tristantech/Dorm-Room-Automation/README.md

Dorm-Room-Automation
====================

Complete automation system for lights, A/V, doors, etc
