tristantech/Dorm-Room-Automation/Documents/DRCS Server Functions.docx

DRCS Control Functions

Lighting

see all channels

set channel, get channel

Audio / Music

now playing (Source name and song tags if available)

volume

play,pause,forward,back buttons for BT source

source

Door Security

current status

allow online door open? (risky)

Window

raise/lower blinds

enable/disable relay

current status (relay state, blind state, and window open sensor state)

Weather

current conditions

past archived weather

Webcam

view current frame

view archived images
