tristantech/Dorm-Room-Automation/Documents/DRCS Server Functions.pages/preview-web.jpg

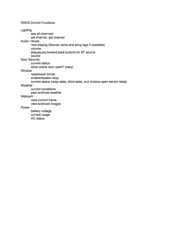
Documents/DRCS Server Functions.pages/preview-web.jpg
