tristantech/Dorm-Room-Automation/(list of files, cad)

Other CAD files:
Drawings/East Campus.dwg
