tristantech/Dorm-Room-Automation/Boards/Lighting/PWM_Board.pdf

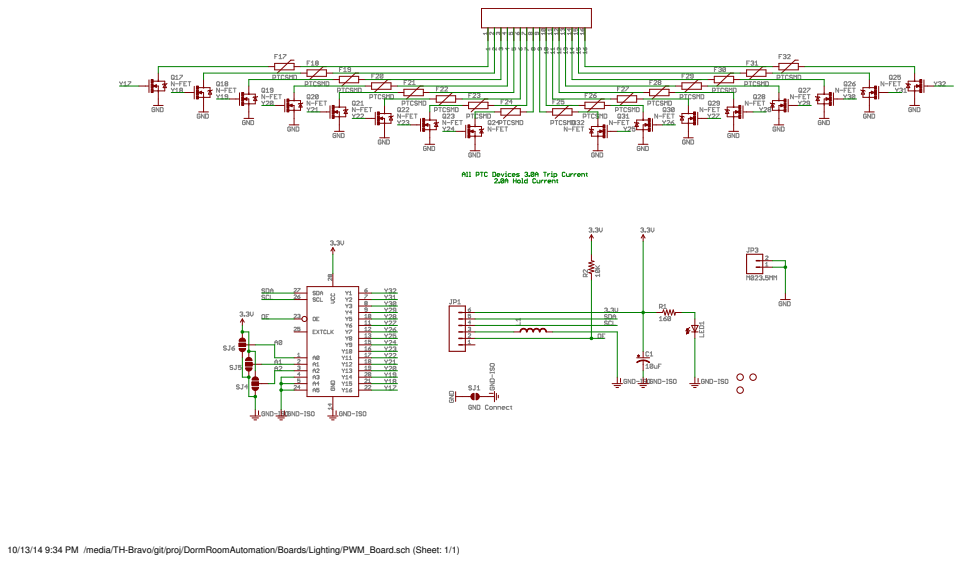
[picture p12: page 1]

10/13/14 9:34 PM /media/TH-Bravo/git/proj/DormRoomAutomation/Boards/Lighting/PWM_Board.sch (Sheet: 1/1)
