tristantech/Dorm-Room-Automation/Boards/plot.pdf

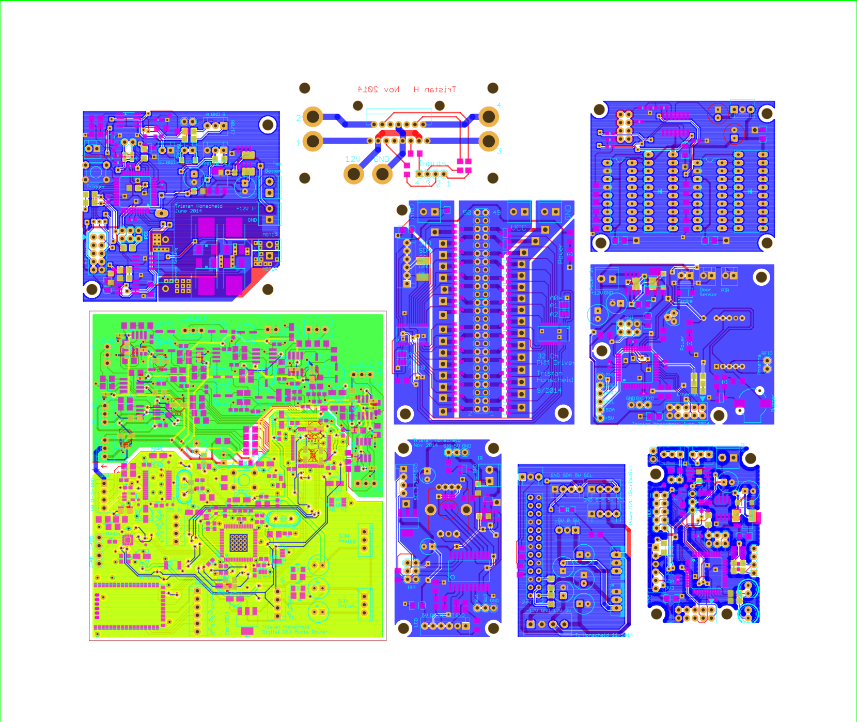
[picture p13: page 1]
