tristantech/Dorm-Room-Automation/Boards/Media/vu.brd

## EAGLE design Boards/Media/vu.brd (2014-12-12)

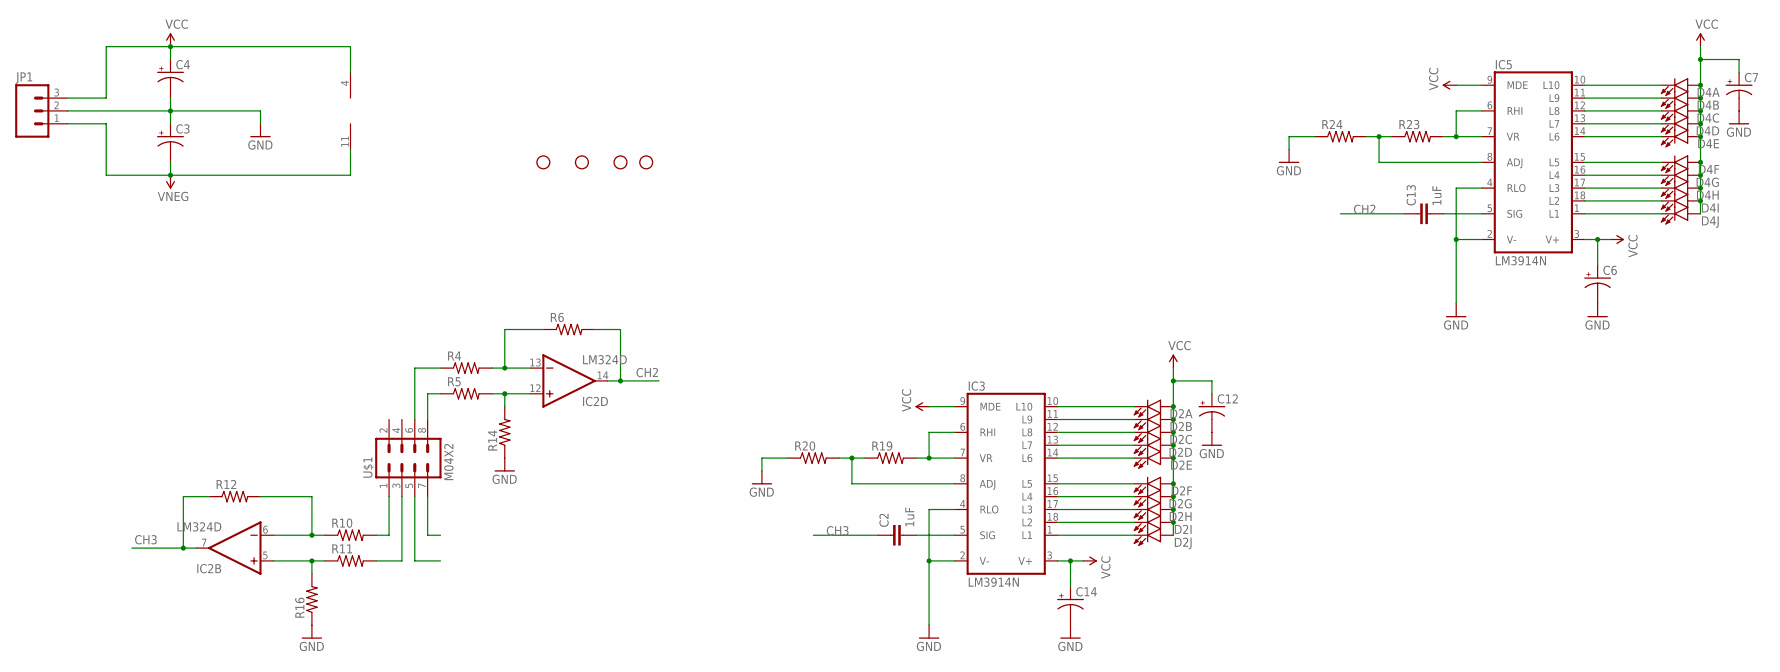
[picture p14: schematic vu.sch]

Parts:
C2, C13: 1uF; 1206
C3, C4: CAP_POLPTH1; CPOL-RADIAL-100UF-25V
C6, C7, C12, C14: CAP_POL1206; EIA3216
D2, D4: LED_BARGRAPH_10; LED_BARGAPH_10
IC2: LM324D; SO14
IC3, IC5: LM3914N; DIL18
JP1: M03POLAR; MOLEX-1X3
R4, R5, R6, R10, R11, R12, R14, R16: RESISTOR0603; 0603-RES
R19, R20, R23, R24: RESISTOR1206; 1206
STANDOFF1, STANDOFF2, STANDOFF3, STANDOFF4: STAND-OFF
U$1: M04X2; 2X4

Connections:
CH2: C13.1, IC2.14 (OUT), R6.2
CH3: C2.1, IC2.7 (OUT), R12.1
GND: C3.1 (+), C4.2 (-), C6.C (-), C7.C (-), C12.C (-), C14.C (-), IC3.2 (V-), IC3.4 (RLO), IC5.2 (V-), IC5.4 (RLO), JP1.2, R14.1, R16.1, R20.1, R24.1
unnamed: R11.2, U$1.3
unnamed: R10.2, U$1.1
unnamed: IC2.12 (+IN), R5.2, R14.2
unnamed: R4.1, U$1.6
unnamed: IC2.6 (-IN), R10.1, R12.2
unnamed: IC2.5 (+IN), R11.1, R16.2
unnamed: R5.1, U$1.8
unnamed: IC2.13 (-IN), R4.2, R6.1
unnamed: D2.19 (C), IC3.11 (L9)
unnamed: D2.18 (C), IC3.12 (L8)
unnamed: D2.17 (C), IC3.13 (L7)
unnamed: D2.16 (C), IC3.14 (L6)
unnamed: D2.15 (C), IC3.15 (L5)
unnamed: D2.14 (C), IC3.16 (L4)
unnamed: D2.13 (C), IC3.17 (L3)
unnamed: D2.12 (C), IC3.18 (L2)
unnamed: D2.11 (C), IC3.1 (L1)
unnamed: D2.20 (C), IC3.10 (L10)
unnamed: C2.2, IC3.5 (SIG)
unnamed: IC3.6 (RHI), IC3.7 (VR), R19.2
unnamed: IC3.8 (ADJ), R19.1, R20.2
unnamed: D4.19 (C), IC5.11 (L9)
unnamed: D4.18 (C), IC5.12 (L8)
unnamed: D4.17 (C), IC5.13 (L7)
unnamed: D4.16 (C), IC5.14 (L6)
unnamed: D4.15 (C), IC5.15 (L5)
unnamed: D4.14 (C), IC5.16 (L4)
unnamed: D4.13 (C), IC5.17 (L3)
unnamed: D4.12 (C), IC5.18 (L2)
unnamed: D4.11 (C), IC5.1 (L1)
unnamed: D4.20 (C), IC5.10 (L10)
unnamed: C13.2, IC5.5 (SIG)
unnamed: IC5.6 (RHI), IC5.7 (VR), R23.2
unnamed: IC5.8 (ADJ), R23.1, R24.2
VCC: C4.1 (+), C6.A (+), C7.A (+), C12.A (+), C14.A (+), D2.1 (A), D2.2 (A), D2.3 (A), D2.4 (A), D2.5 (A), D2.6 (A), D2.7 (A), D2.8 (A), D2.9 (A), D2.10 (A), D4.1 (A), D4.2 (A), D4.3 (A), D4.4 (A), D4.5 (A), D4.6 (A), D4.7 (A), D4.8 (A), D4.9 (A), D4.10 (A), IC2.4 (V+), IC3.3 (V+), IC3.9 (MDE), IC5.3 (V+), IC5.9 (MDE), JP1.3
VNEG: C3.2 (-), IC2.11 (V-), JP1.1

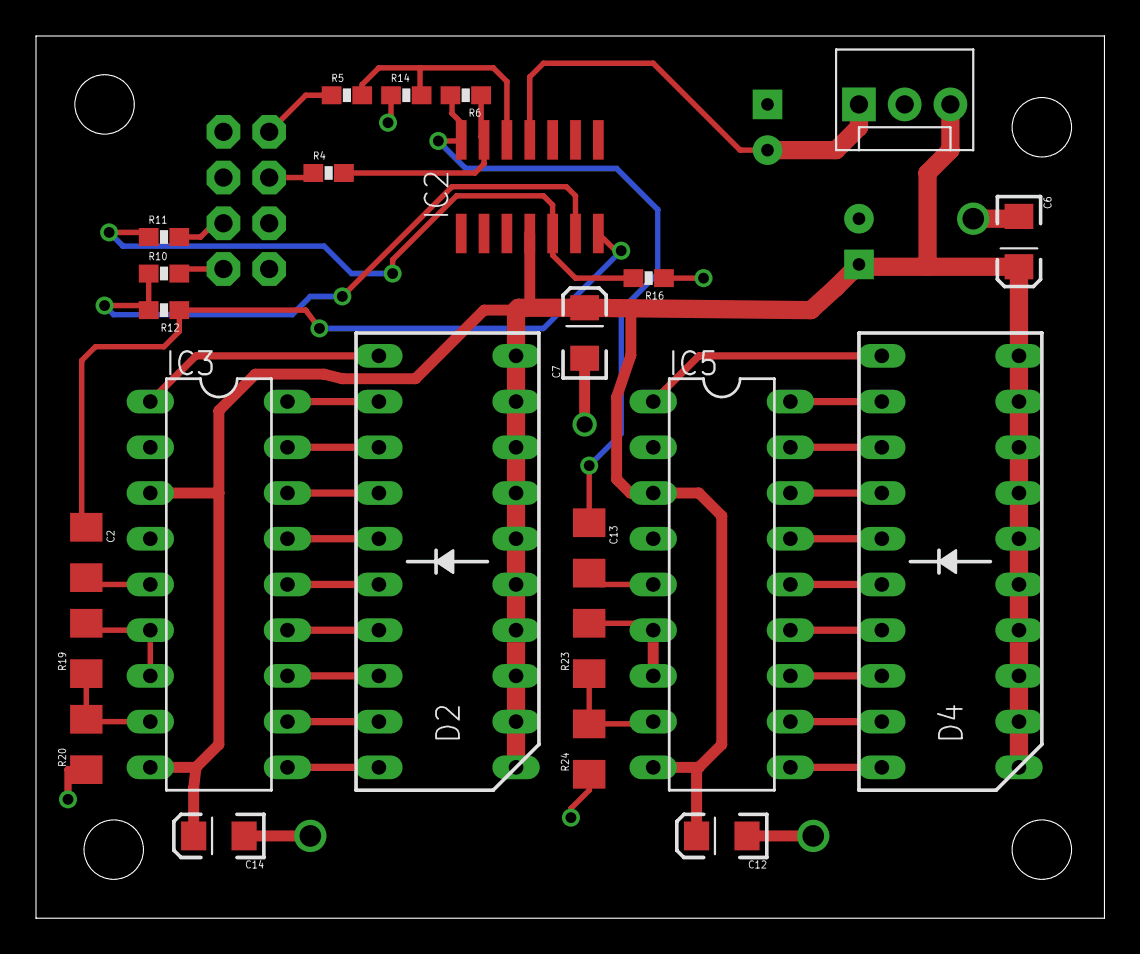
[picture p15: board vu.brd from above]

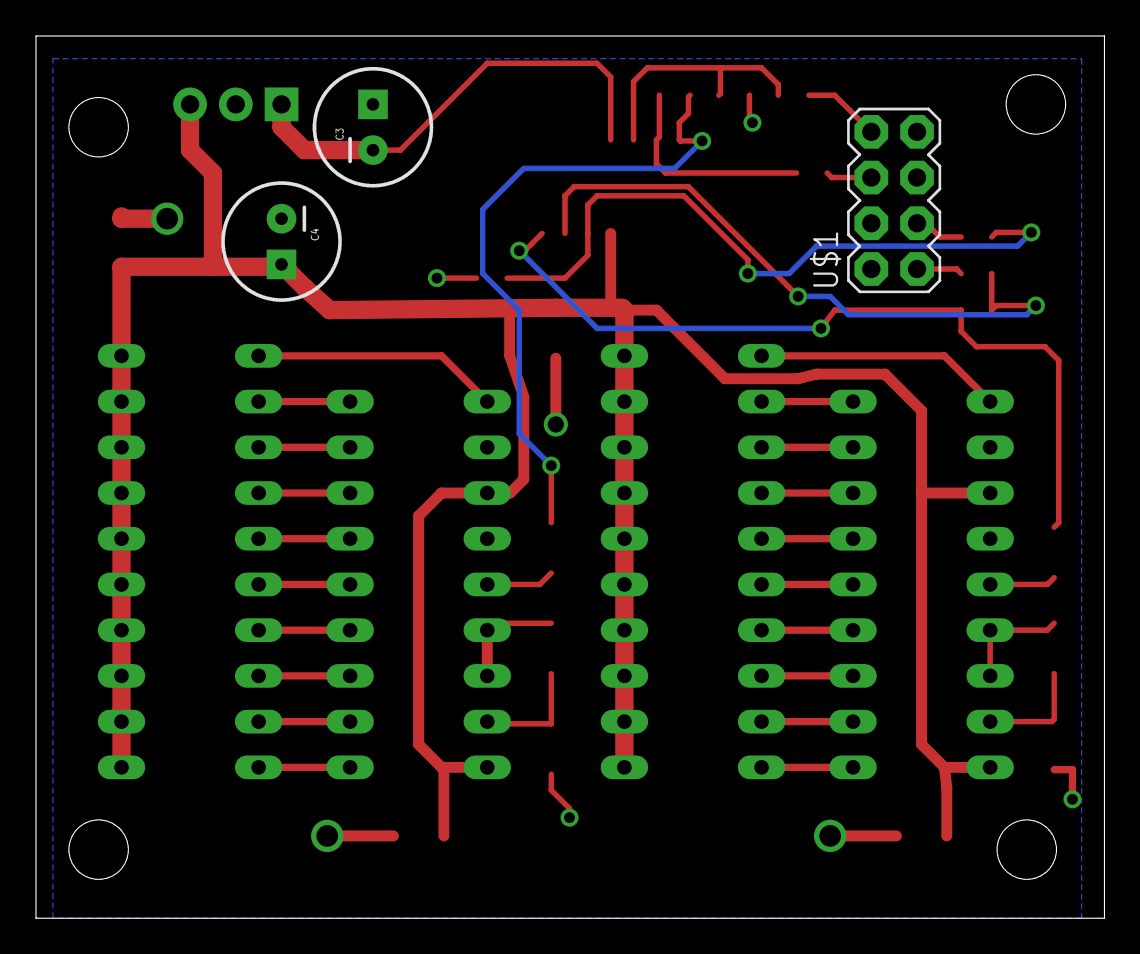
[picture p16: board vu.brd from below]

Board: 2 copper layers, 59.4 x 49.0 mm, 31 parts (3 on the bottom side), 39 nets.
