tristantech/Dorm-Room-Automation/Boards/Media/dsp.brd

## EAGLE design Boards/Media/dsp.brd (2014-12-12)

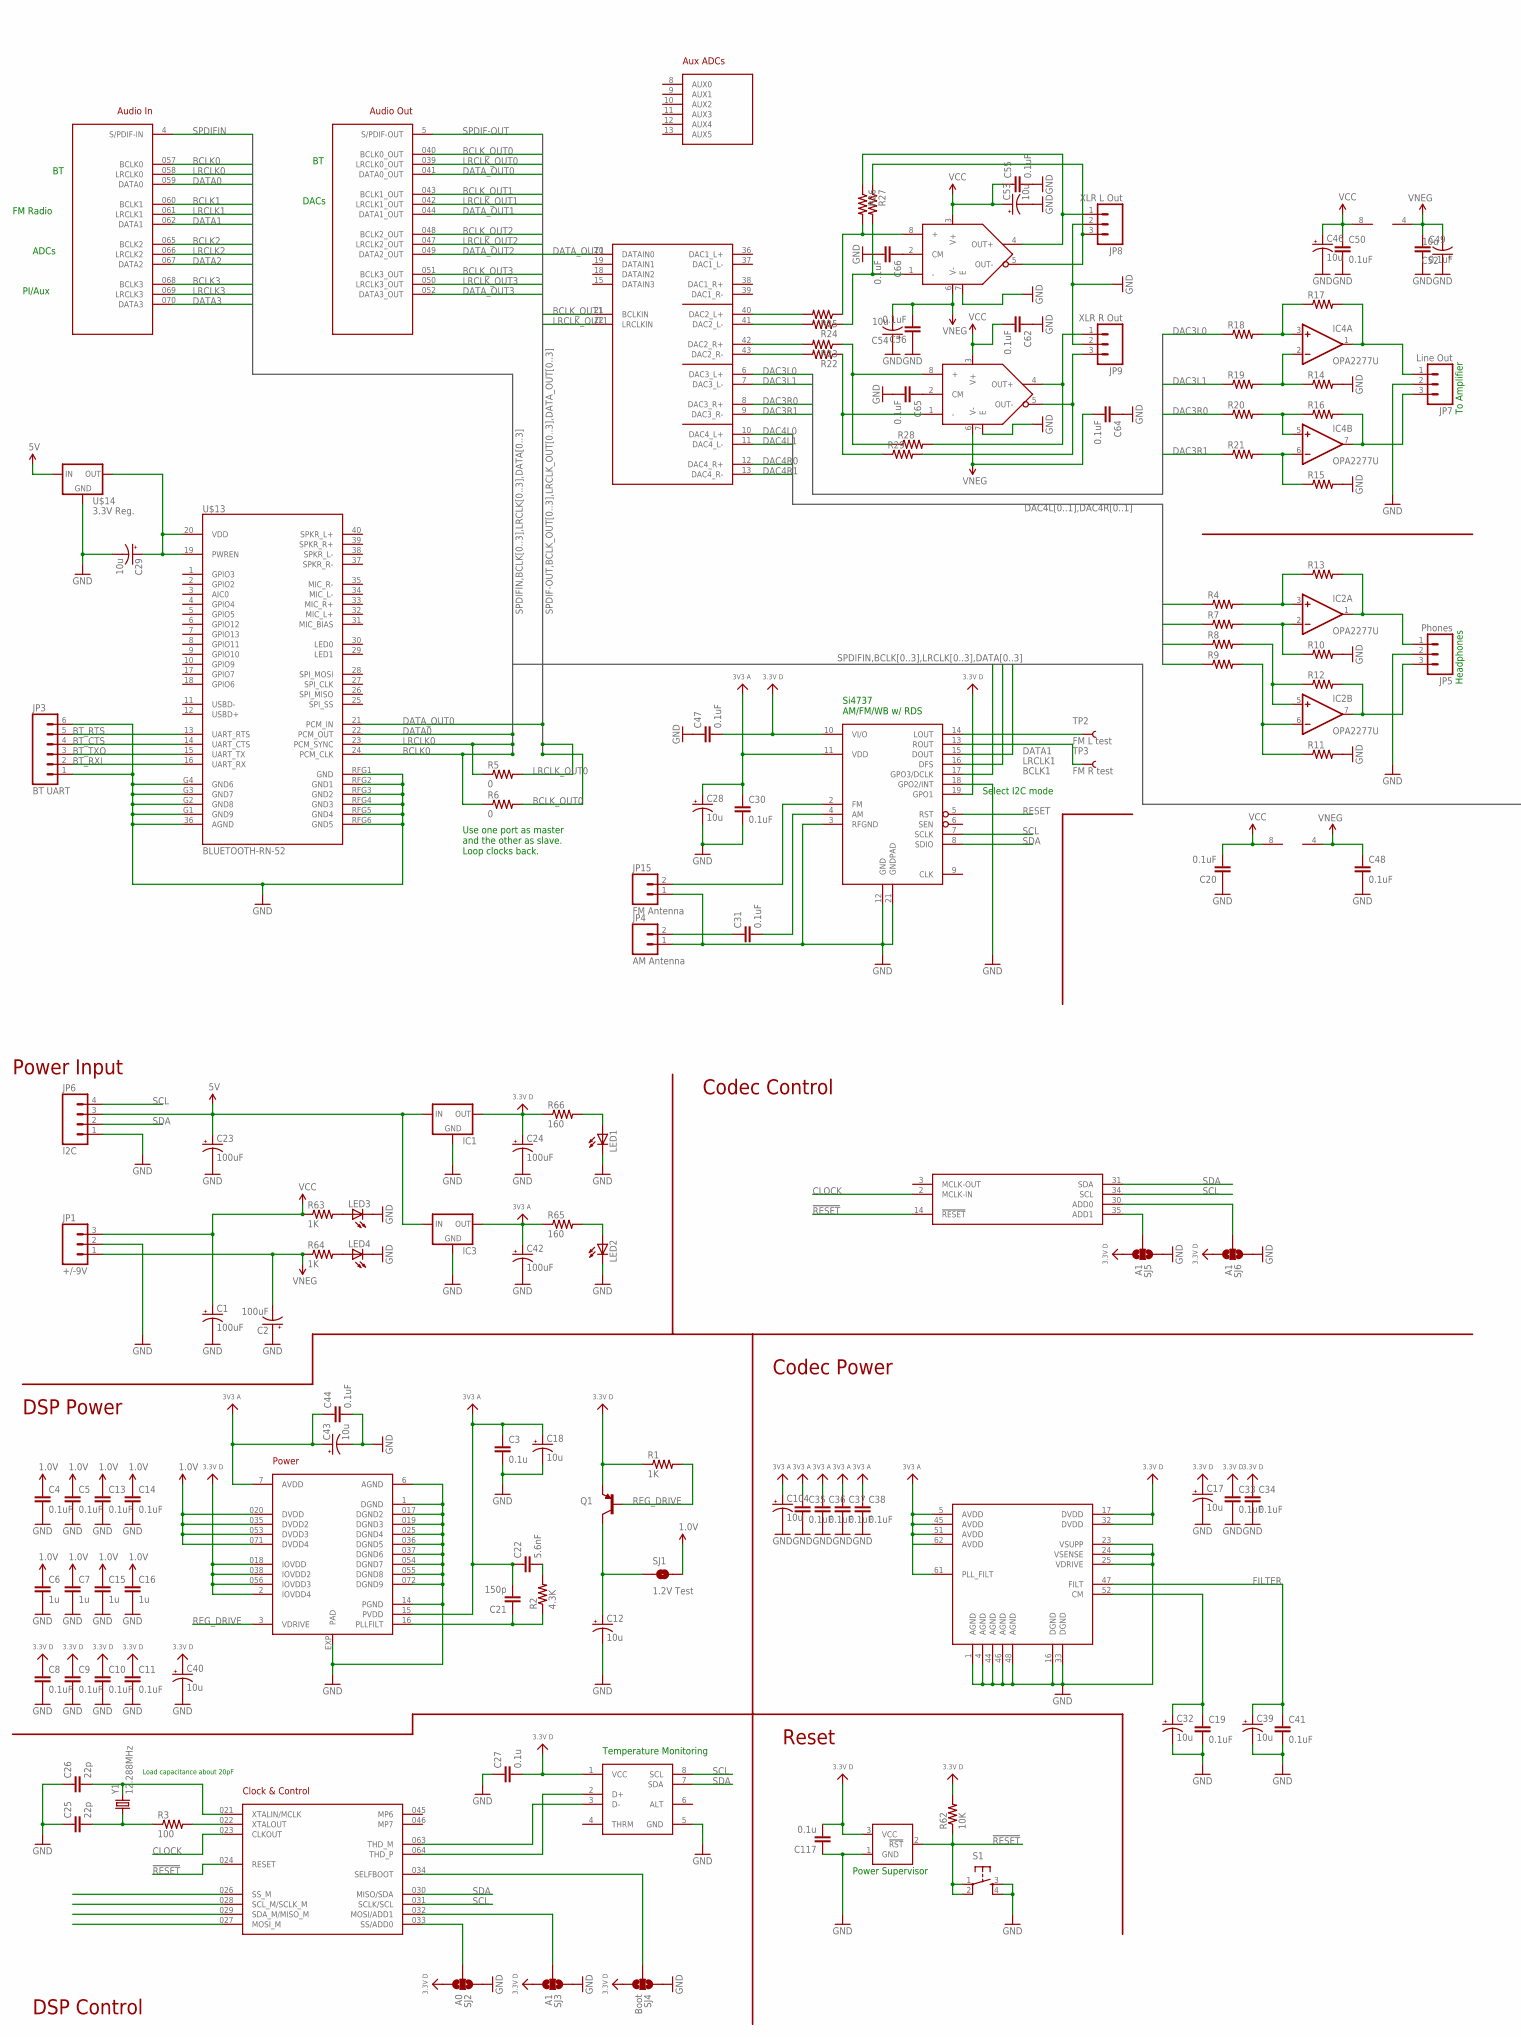
[picture p17: schematic dsp.sch, sheet 1, part in row 1, column 1]

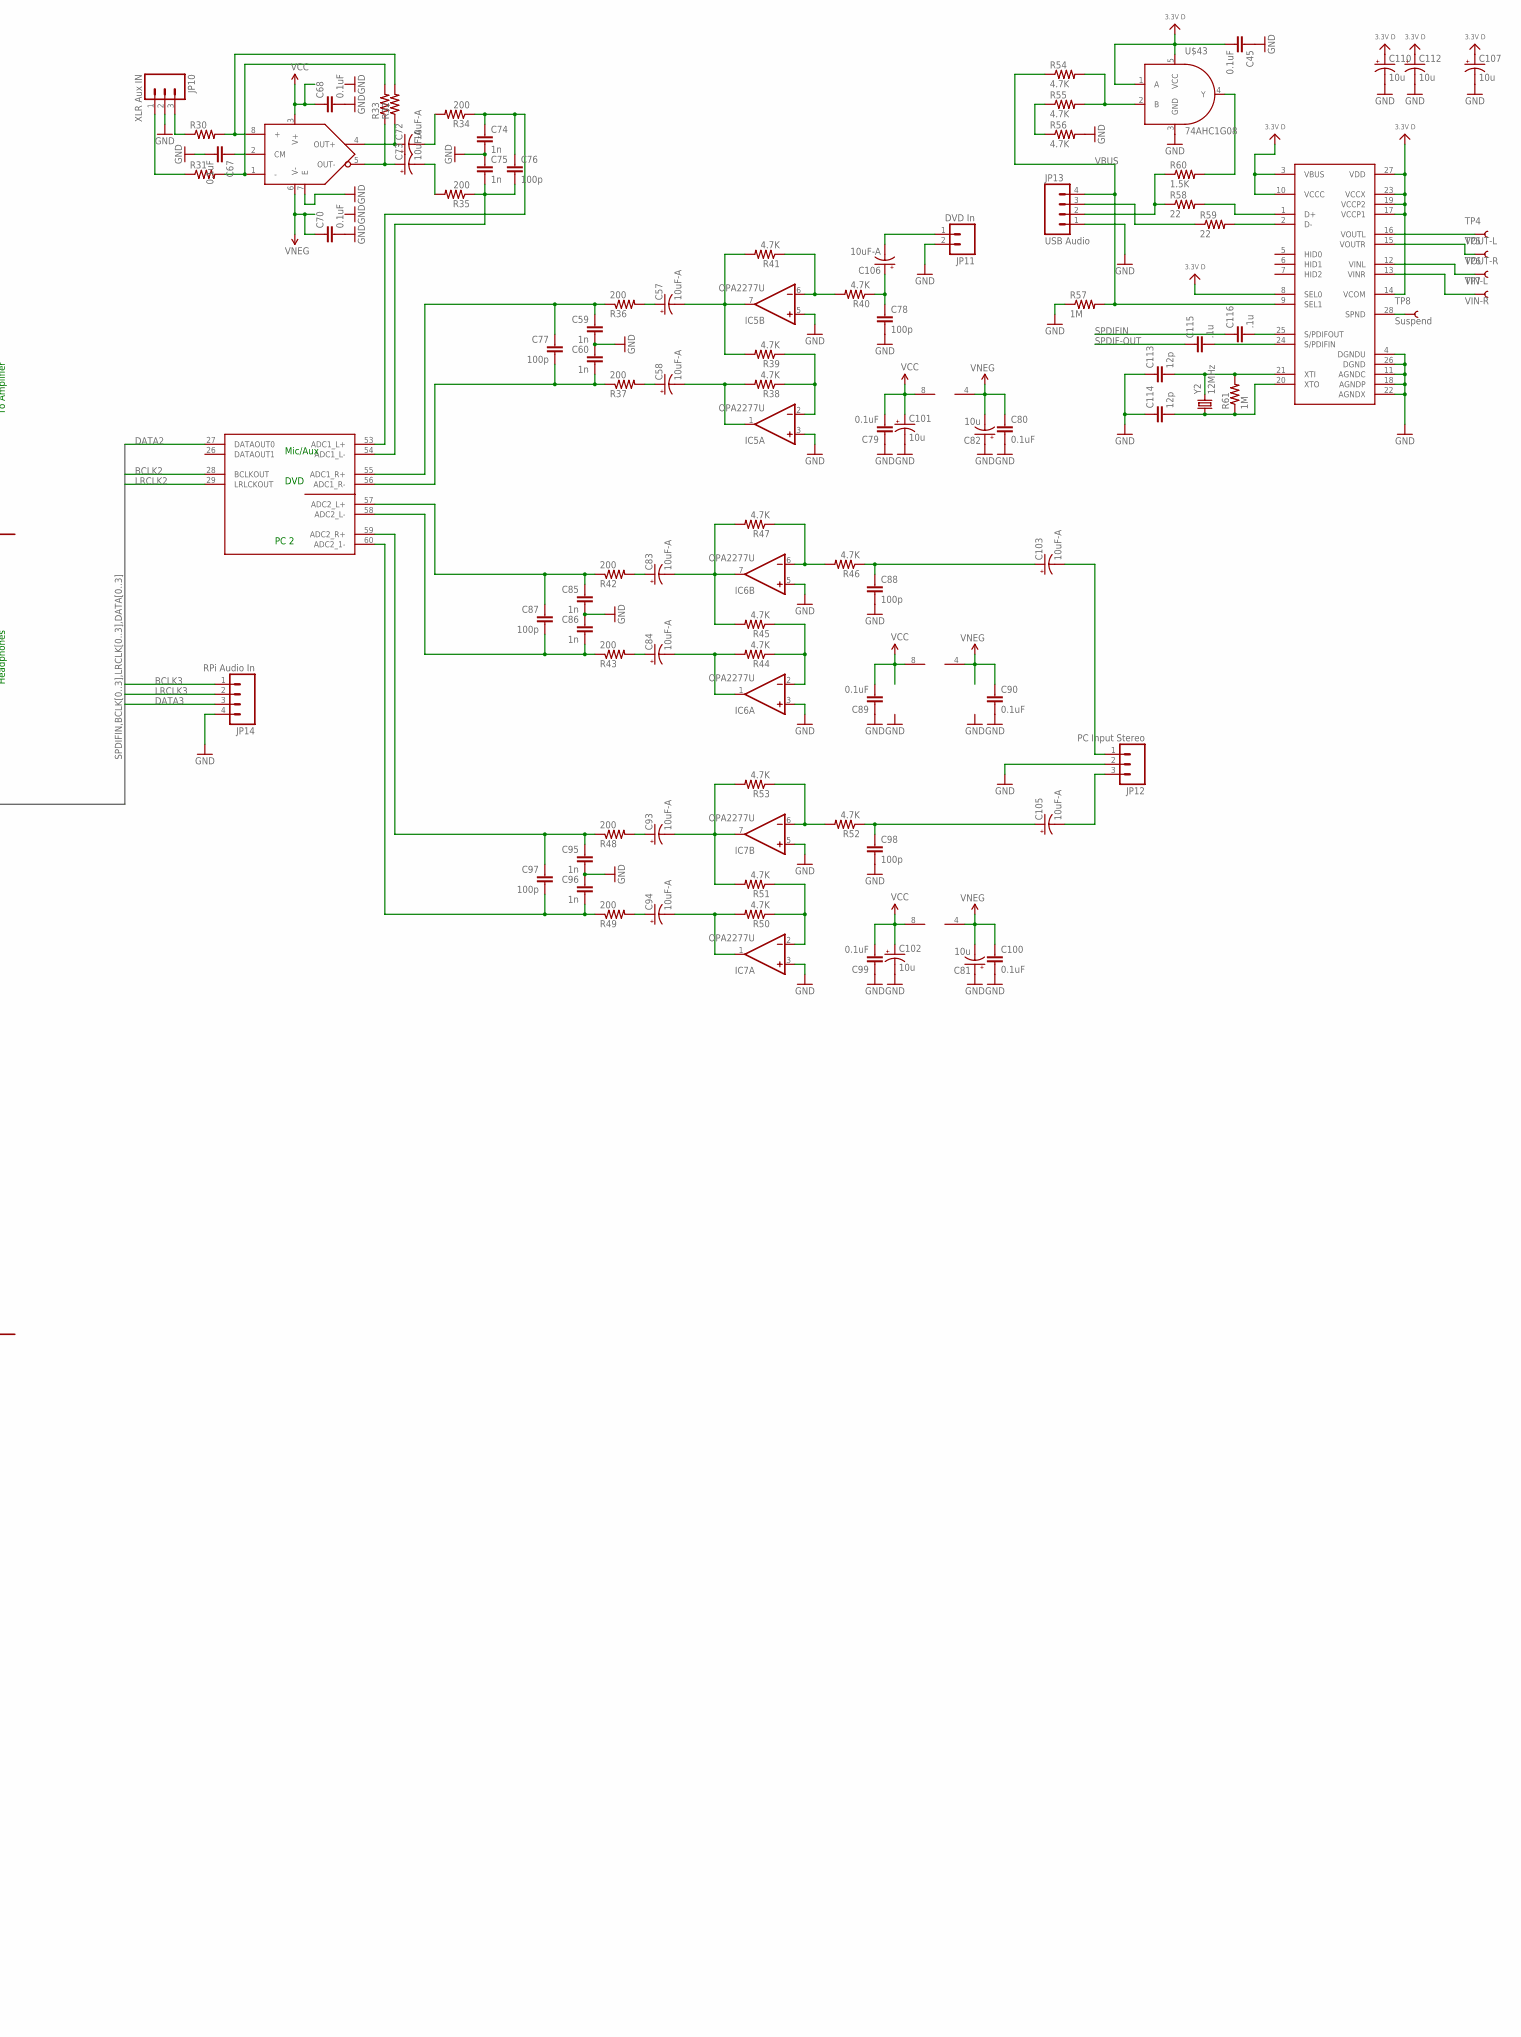
[picture p18: schematic dsp.sch, sheet 1, part in row 1, column 2]

Parts:
C1, C2, C23, C24, C42: 100uF; CPOL-RADIAL-100UF-25V
C3, C27, C117: 0.1u; 0603-CAP
C4, C5, C8, C9, C10, C11, C13, C14, C19, C20, C30, C31, C33, C34, C35, C36, C37, C38, C41, C44, C45, C47, C48, C49, C50, C55, C56, C62, C64, C65, C66, C67, C68, C70, C79, C80, C89, C90, C99, C100: 0.1uF; 0603-CAP
C6, C7, C15, C16: 1u; 0603-CAP
C12, C17, C18, C28, C29, C32, C39, C40, C43, C46, C52, C53, C54, C81, C82, C101, C102, C104, C107, C110, C112: 10u; PANASONIC_B
C21: 150p; 0603-CAP
C22: 5.6nF; 0603-CAP
C25, C26: 22p; 0603-CAP
C57, C58, C72, C73, C83, C84, C93, C94, C103, C105, C106: 10uF-A; PANASONIC_C
C59, C60, C74, C75, C85, C86, C95, C96: 1n; 0603-CAP
C76, C77, C78, C87, C88, C97, C98: 100p; 0603-CAP
C113, C114: 12p; 0603-CAP
C115, C116: .1u; 0603-CAP
IC1, IC3: V_REG_78XXSINK; TO220-IGO
IC2, IC4, IC5, IC6, IC7: OPA2277U; SO08
JP1: +/-9V; MOLEX-1X3
JP3: BT UART; MOLEX-1X6
JP4: AM Antenna; 1X02
JP5: Phones; MOLEX-1X3
JP6: I2C; MOLEX-1X4
JP7: Line Out; MOLEX-1X3
JP8: XLR L Out; MOLEX-1X3
JP9: XLR R Out; MOLEX-1X3
JP10: XLR Aux IN; MOLEX-1X3
JP11: DVD In; MOLEX-1X2
JP12: PC Input Stereo; MOLEX-1X3
JP13: USB Audio; MOLEX-1X4
JP14: RPi Audio In; MOLEX-1X4
JP15: FM Antenna; 1X02
LED1, LED2, LED3, LED4: LED1206; LED-1206
Q1: TRANSISTOR_PNPSMD; SOT23-3
R1, R63, R64: 1K; 1206
R2: 4.3K; 1206
R3: 100; 1206
R4, R7, R8, R9, R10, R11, R12, R13, R14, R15, R16, R17, R18, R19, R20, R21, R22, R23, R24, R25, R26, R27, R28, R29, R30, R31, R32, R33: RESISTOR1206; 1206
R5, R6: 0; 1206
R34, R35, R36, R37, R42, R43, R48, R49: 200; 1206
R38, R39, R40, R41, R44, R45, R46, R47, R50, R51, R52, R53, R54, R55, R56: 4.7K; 1206
R57, R61: 1M; 1206
R58, R59: 22; 1206
R60: 1.5K; 1206
R62: 10K; 1206
R65, R66: 160; 1206
S1: TAC_SWITCHPTH; TACTILE-PTH
SJ1: 1.2V Test; SJ_2S-NO
SJ2: A0; SJ_3
SJ3, SJ5, SJ6: A1; SJ_3
SJ4: Boot; SJ_3
TP2: FM L test; PAD.03X.03
TP3: FM R test; PAD.03X.03
TP4: VOUT-L; PAD.03X.03
TP5: VOUT-R; PAD.03X.03
TP6: VIN-L; PAD.03X.03
TP7: VIN-R; PAD.03X.03
TP8: Suspend; PAD.03X.03
U$1: ADAU1451; LFCSP-72
U$8: ADM1032; MSOP-8
U$13: BLUETOOTH-RN-52; RN-52
U$14: 3.3V Reg.; SOT223
U$15: SI4736/37/38/39; QFN-16
U$17: AD1937; LQFP-64
U$35, U$38, U$39: LME49724; SOIC-8
U$40: PCM2903; SSOP-28
U$43: 74AHC1G08; SOT23-5
U$52: TLV803; SOT23
Y1: 12.288MHz; HC49U-V
Y2: 12MHz; HC49U-V

Connections:
1.0V: C4.1, C5.1, C6.1, C7.1, C13.1, C14.1, C15.1, C16.1, SJ1.2, U$1.020 (DVDD), U$1.035 (DVDD2), U$1.053 (DVDD3), U$1.071 (DVDD4)
3.3V_A: C3.1, C18.+, C21.2, C22.1, C28.+, C30.1, C35.1, C36.1, C37.1, C38.1, C42.1 (+), C43.+, C44.1, C104.+, IC3.OUT, R65.1, U$1.7 (AVDD), U$1.15 (PVDD), U$15.11 (VDD), U$17.5 (AVDD), U$17.45 (AVDD), U$17.51 (AVDD), U$17.61 (PLL_FILT), U$17.62 (AVDD)
3V3_D: C8.1, C9.1, C10.1, C11.1, C17.+, C24.1 (+), C27.2, C33.1, C34.1, C40.+, C45.2, C47.2, C107.+, C110.+, C112.+, C117.2, IC1.OUT, Q1.2 (E), R1.1, R62.2, R66.1, SJ2.3, SJ3.3, SJ4.3, SJ5.3, SJ6.3, U$1.2 (IOVDD4), U$1.018 (IOVDD), U$1.038 (IOVDD2), U$1.056 (IOVDD3), U$8.1 (VCC), U$15.10 (VI/O), U$15.19 (GPO1), U$17.17 (DVDD), U$17.32 (DVDD), U$40.3 (VBUS), U$40.8 (SEL0), U$40.10 (VCCC), U$40.14 (VCOM), U$40.17 (VCCP1), U$40.19 (VCCP2), U$40.23 (VCCX), U$40.27 (VDD), U$43.1 (A), U$43.5 (VCC), U$52.3 (VCC)
5V: C23.1 (+), IC1.IN, IC3.IN, JP6.3, U$14.1 (IN)
!RESET: R62.1, S1.1, S1.2, U$1.024 (RESET), U$17.14 (!RESET), U$52.2 (!RST)
BCLK0: R6.1, U$1.057 (BCLK0), U$13.24 (PCM_CLK)
BCLK1: U$1.060 (BCLK1), U$15.17 (GPO3/DCLK)
BCLK2: U$1.065 (BCLK2), U$17.28 (BCLKOUT)
BCLK3: JP14.1, U$1.068 (BCLK3)
BCLK_OUT0: R6.2, U$1.040 (BCLK0_OUT)
BCLK_OUT1: U$1.043 (BCLK1_OUT), U$17.21 (BCLKIN)
BCLK_OUT2: U$1.048 (BCLK2_OUT)
BCLK_OUT3: U$1.051 (BCLK3_OUT)
BT_CTS: JP3.4, U$13.14 (UART_CTS)
BT_RTS: JP3.5, U$13.13 (UART_RTS)
BT_RXI: JP3.2, U$13.16 (UART_RX)
BT_TXO: JP3.3, U$13.15 (UART_TX)
CLOCK: U$1.023 (CLKOUT), U$17.2 (MCLK-IN)
DAC3L0: R18.1, U$17.6 (DAC3_L+)
DAC3L1: R19.1, U$17.7 (DAC3_L-)
DAC3R0: R20.1, U$17.8 (DAC3_R+)
DAC3R1: R21.1, U$17.9 (DAC3_R-)
DAC4L0: R4.1, U$17.10 (DAC4_L+)
DAC4L1: R7.1, U$17.11 (DAC4_L-)
DAC4R0: R8.1, U$17.12 (DAC4_R+)
DAC4R1: R9.1, U$17.13 (DAC4_R-)
DATA0: U$1.059 (DATA0), U$13.22 (PCM_OUT)
DATA1: U$1.062 (DATA1), U$15.15 (DOUT)
DATA2: U$1.067 (DATA2), U$17.27 (DATAOUT0)
DATA3: JP14.3, U$1.070 (DATA3)
DATA_OUT0: U$1.041 (DATA0_OUT), U$13.21 (PCM_IN)
DATA_OUT1: U$1.044 (DATA1_OUT), U$17.20 (DATAIN0)
DATA_OUT2: U$1.049 (DATA2_OUT)
DATA_OUT3: U$1.052 (DATA3_OUT)
FILTER: C39.+, C41.1, U$17.47 (FILT)
FM: JP15.2, U$15.2 (FM)
GND: C1.2 (-), C2.1 (+), C3.2, C4.2, C5.2, C6.2, C7.2, C8.2, C9.2, C10.2, C11.2, C12.-, C13.2, C14.2, C15.2, C16.2, C17.-, C18.-, C19.2, C20.1, C23.2 (-), C24.2 (-), C25.1, C26.1, C27.1, C28.-, C29.-, C30.2, C32.-, C33.2, C34.2, C35.2, C36.2, C37.2, C38.2, C39.-, C40.-, C41.2, C42.2 (-), C43.-, C44.2, C45.1, C46.-, C47.1, C48.2, C49.2, C50.2, C52.+, C53.-, C54.+, C55.2, C56.1, C59.2, C60.1, C62.1, C64.1, C65.2, C66.2, C67.2, C68.2, C70.2, C74.2, C75.1, C78.2, C79.1, C80.2, C81.+, C82.+, C85.2, C86.1, C88.2, C89.1, C90.2, C95.2, C96.1, C98.2, C99.1, C100.2, C101.-, C102.-, C104.-, C107.-, C110.-, C112.-, C113.1, C114.1, C117.1, IC1.GND, IC3.GND, IC5.3 (+IN), IC5.5 (+IN), IC6.3 (+IN), IC6.5 (+IN), IC7.3 (+IN), IC7.5 (+IN), JP1.2, JP3.1, JP3.6, JP4.1, JP5.2, JP6.1, JP7.2, JP8.2, JP9.2, JP10.2, JP11.2, JP12.2, JP13.1, JP14.4, JP15.1, LED1.C, LED2.C, LED3.C, LED4.C, R10.2, R11.2, R14.2, R15.2, R56.2, R57.1, S1.3, S1.4, SJ2.1, SJ3.1, SJ4.1, SJ5.1, SJ6.1, U$1.1 (DGND), U$1.6 (AGND), U$1.14 (PGND), U$1.017 (DGND2), U$1.019 (DGND3), U$1.025 (DGND4), U$1.036 (DGND5), U$1.037 (DGND6), U$1.054 (DGND7), U$1.055 (DGND8), U$1.072 (DGND9), U$1.EXP (PAD), U$8.5 (GND), U$13.36 (AGND), U$13.G1 (GND9), U$13.G2 (GND8), U$13.G3 (GND7), U$13.G4 (GND6), U$13.RFG1 (GND), U$13.RFG2 (GND1), U$13.RFG3 (GND2), U$13.RFG4 (GND3), U$13.RFG5 (GND4), U$13.RFG6 (GND5), U$14.2 (GND), U$15.3 (RFGND), U$15.12 (GND), U$15.18 (GPO2/INT), U$15.21 (GNDPAD), U$17.1 (AGND), U$17.4 (AGND), U$17.16 (DGND), U$17.23 (VSUPP), U$17.24 (VSENSE), U$17.25 (VDRIVE), U$17.33 (DGND), U$17.44 (AGND), U$17.46 (AGND), U$17.48 (AGND), U$35.7 (E), U$38.7 (E), U$39.7 (E), U$40.4 (DGNDU), U$40.11 (AGNDC), U$40.18 (AGNDP), U$40.22 (AGNDX), U$40.26 (DGND), U$43.3 (GND), U$52.1 (GND)
LRCLK0: R5.1, U$1.058 (LRCLK0), U$13.23 (PCM_SYNC)
LRCLK1: U$1.061 (LRCLK1), U$15.16 (DFS)
LRCLK2: U$1.066 (LRCLK2), U$17.29 (LRLCKOUT)
LRCLK3: JP14.2, U$1.069 (LRCLK3)
LRCLK_OUT0: R5.2, U$1.039 (LRCLK0_OUT)
LRCLK_OUT1: U$1.042 (LRCLK1_OUT), U$17.22 (LRCLKIN)
LRCLK_OUT2: U$1.047 (LRCLK2_OUT)
LRCLK_OUT3: U$1.050 (LRCLK3_OUT)
unnamed: C21.1, R2.1, U$1.16 (PLLFILT)
unnamed: C22.2, R2.2
unnamed: R3.2, U$1.022 (XTALOUT)
unnamed: C12.+, Q1.3 (C), SJ1.1
unnamed: C26.2, U$1.021 (XTALIN/MCLK), Y1.2
unnamed: C25.2, R3.1, Y1.1
unnamed: C19.1, C32.+, U$17.52 (CM)
unnamed: U$1.063 (THD_M), U$8.3 (D-)
unnamed: U$1.064 (THD_P), U$8.2 (D+)
unnamed: SJ4.2, U$1.034 (SELFBOOT)
unnamed: SJ3.2, U$1.032 (MOSI/ADD1)
unnamed: SJ2.2, U$1.033 (SS/ADD0)
unnamed: C29.+, U$13.19 (PWREN), U$13.20 (VDD), U$14.3 (OUT)
unnamed: IC2.1 (OUT), JP5.1, R13.2
unnamed: IC2.3 (+IN), R4.2, R13.1
unnamed: C31.2, U$15.4 (AM)
unnamed: C31.1, JP4.2
unnamed: TP2.P$1, U$15.14 (LOUT)
unnamed: TP3.P$1, U$15.13 (ROUT)
unnamed: IC2.2 (-IN), R7.2, R10.1
unnamed: SJ5.2, U$17.35 (ADD1)
unnamed: SJ6.2, U$17.30 (ADD0)
unnamed: IC2.5 (+IN), R8.2, R12.1
unnamed: IC2.6 (-IN), R9.2, R11.1
unnamed: IC4.7 (OUT), JP7.3, R16.2
unnamed: IC4.1 (OUT), JP7.1, R17.2
unnamed: IC2.7 (OUT), JP5.3, R12.2
unnamed: IC4.3 (+IN), R17.1, R18.2
unnamed: IC4.2 (-IN), R14.1, R19.2
unnamed: IC4.5 (+IN), R16.1, R20.2
unnamed: IC4.6 (-IN), R15.1, R21.2
unnamed: C73.+, R33.1, U$39.5 (OUT-)
unnamed: JP9.1, R28.2, U$38.4 (OUT+)
unnamed: JP9.3, R29.2, U$38.5 (OUT-)
unnamed: JP8.1, R26.1, U$35.4 (OUT+)
unnamed: JP8.3, R27.1, U$35.5 (OUT-)
unnamed: R24.2, U$17.41 (DAC2_L-)
unnamed: C66.1, U$35.2 (CM)
unnamed: C65.1, U$38.2 (CM)
unnamed: R25.2, U$17.40 (DAC2_L+)
unnamed: R23.2, U$17.42 (DAC2_R+)
unnamed: R22.2, U$17.43 (DAC2_R-)
unnamed: C72.+, R32.1, U$39.4 (OUT+)
unnamed: R25.1, R26.2, U$35.8 (+)
unnamed: R24.1, R27.2, U$35.1 (-)
unnamed: R23.1, R28.1, U$38.8 (+)
unnamed: R22.1, R29.1, U$38.1 (-)
unnamed: C67.1, U$39.2 (CM)
unnamed: C72.-, R34.2
unnamed: C73.-, R35.2
unnamed: C57.+, R36.2
unnamed: R30.2, R32.2, U$39.8 (+)
unnamed: JP10.3, R30.1
unnamed: JP10.1, R31.1
unnamed: R31.2, R33.2, U$39.1 (-)
unnamed: C75.2, C76.2, R35.1, U$17.54 (ADC1_L-)
unnamed: C58.+, R37.2
unnamed: C74.1, C76.1, R34.1, U$17.53 (ADC1_L+)
unnamed: C60.2, C77.2, R37.1, U$17.56 (ADC1_R-)
unnamed: C59.1, C77.1, R36.1, U$17.55 (ADC1_R+)
unnamed: C58.-, IC5.1 (OUT), R38.2
unnamed: C57.-, IC5.7 (OUT), R39.2, R41.2
unnamed: IC5.2 (-IN), R38.1, R39.1
unnamed: IC5.6 (-IN), R40.2, R41.1
unnamed: C106.-, JP11.1
unnamed: C83.+, R42.2
unnamed: C86.2, C87.2, R43.1, U$17.58 (ADC2_L-)
unnamed: C85.1, C87.1, R42.1, U$17.57 (ADC2_L+)
unnamed: C84.+, R43.2
unnamed: C83.-, IC6.7 (OUT), R45.2, R47.2
unnamed: C84.-, IC6.1 (OUT), R44.2
unnamed: IC6.2 (-IN), R44.1, R45.1
unnamed: IC6.6 (-IN), R46.2, R47.1
unnamed: C88.1, C103.+, R46.1
unnamed: C93.+, R48.2
unnamed: C96.2, C97.2, R49.1, U$17.60 (ADC2_1-)
unnamed: C95.1, C97.1, R48.1, U$17.59 (ADC2_R+)
unnamed: C94.+, R49.2
unnamed: C93.-, IC7.7 (OUT), R51.2, R53.2
unnamed: C94.-, IC7.1 (OUT), R50.2
unnamed: IC7.2 (-IN), R50.1, R51.1
unnamed: IC7.6 (-IN), R52.2, R53.1
unnamed: C98.1, C105.+, R52.1
unnamed: C103.-, JP12.1
unnamed: C105.-, JP12.3
unnamed: C78.1, C106.+, R40.1
unnamed: TP4.P$1, U$40.16 (VOUTL)
unnamed: TP5.P$1, U$40.15 (VOUTR)
unnamed: TP6.P$1, U$40.12 (VINL)
unnamed: TP7.P$1, U$40.13 (VINR)
unnamed: JP13.2, R58.1, R60.1
unnamed: R58.2, U$40.1 (D+)
unnamed: R54.2, R55.2, U$43.2 (B)
unnamed: R59.2, U$40.2 (D-)
unnamed: R55.1, R56.1
unnamed: JP13.3, R59.1
unnamed: R60.2, U$43.4 (Y)
unnamed: C113.2, R61.2, U$40.21 (XTI), Y2.2
unnamed: TP8.P$1, U$40.28 (SPND)
unnamed: C114.2, R61.1, U$40.20 (XTO), Y2.1
unnamed: C115.2, U$40.24 (S/PDIFIN)
unnamed: C116.2, U$40.25 (S/PDIFOUT)
unnamed: LED3.A, R63.2
unnamed: LED4.A, R64.2
unnamed: LED1.A, R66.2
unnamed: LED2.A, R65.2
REG_DRIVE: Q1.1 (B), R1.2, U$1.3 (VDRIVE)
RESET: U$15.5 (RST)
SCL: JP6.4, U$1.031 (SCLK/SCL), U$8.8 (SCL), U$15.7 (SCLK), U$17.34 (SCL)
SDA: JP6.2, U$1.030 (MISO/SDA), U$8.7 (SDA), U$15.8 (SDIO), U$17.31 (SDA)
SPDIF-OUT: C115.1, U$1.5 (S/PDIF-OUT)
SPDIFIN: C116.1, U$1.4 (S/PDIF-IN)
VBUS: JP13.4, R54.1, R57.2, U$40.9 (SEL1)
VCC: C1.1 (+), C20.2, C46.+, C50.1, C53.+, C55.1, C62.2, C68.1, C79.2, C89.2, C99.2, C101.+, C102.+, IC2.8 (V+), IC4.8 (V+), IC5.8 (V+), IC6.8 (V+), IC7.8 (V+), JP1.3, R63.1, U$35.3 (V+), U$38.3 (V+), U$39.3 (V+)
VNEG: C2.2 (-), C48.1, C49.1, C52.-, C54.-, C56.2, C64.2, C70.1, C80.1, C81.-, C82.-, C90.1, C100.1, IC2.4 (V-), IC4.4 (V-), IC5.4 (V-), IC6.4 (V-), IC7.4 (V-), JP1.1, R64.1, U$35.6 (V-), U$38.6 (V-), U$39.6 (V-)

Notes on the sheet:
Load capacitance about 20pF
Temperature Monitoring
Use one port as master and the other as slave. Loop clocks back.
Si4737 AM/FM/WB w/ RDS
FM Radio
Select I2C mode
Power Input
DSP Power
DSP Control
Codec Power
Codec Control
Headphones
To Amplifier
Mic/Aux
PC 2
DVD
ADCs
DACs
Reset
PI/Aux
Power Supervisor

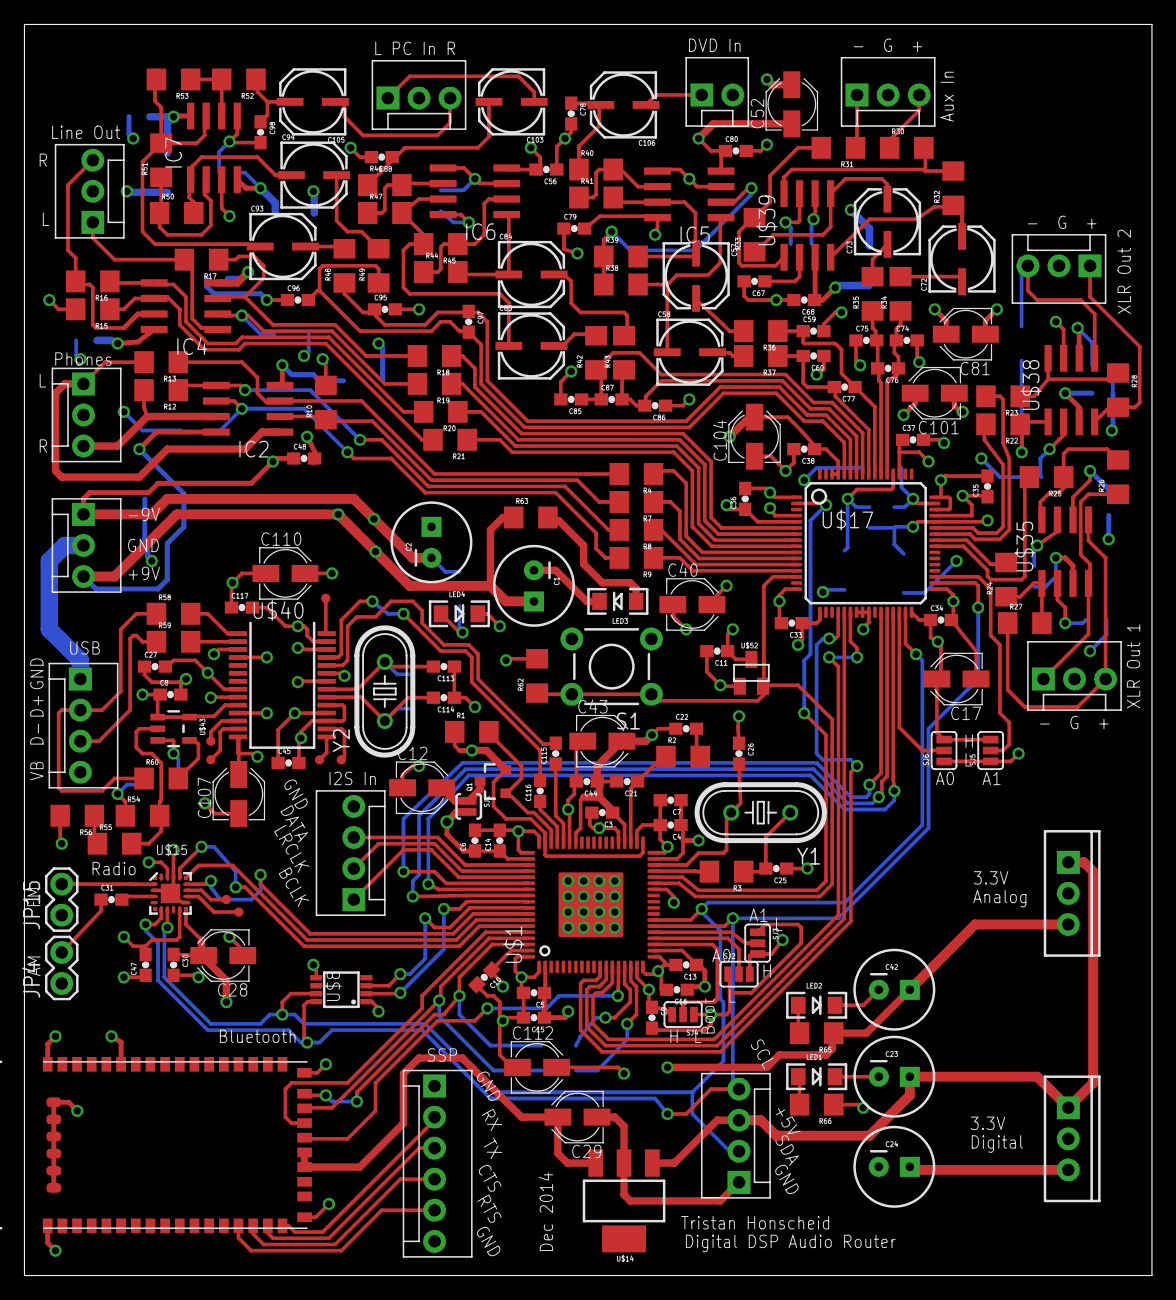
[picture p19: board dsp.brd from above]

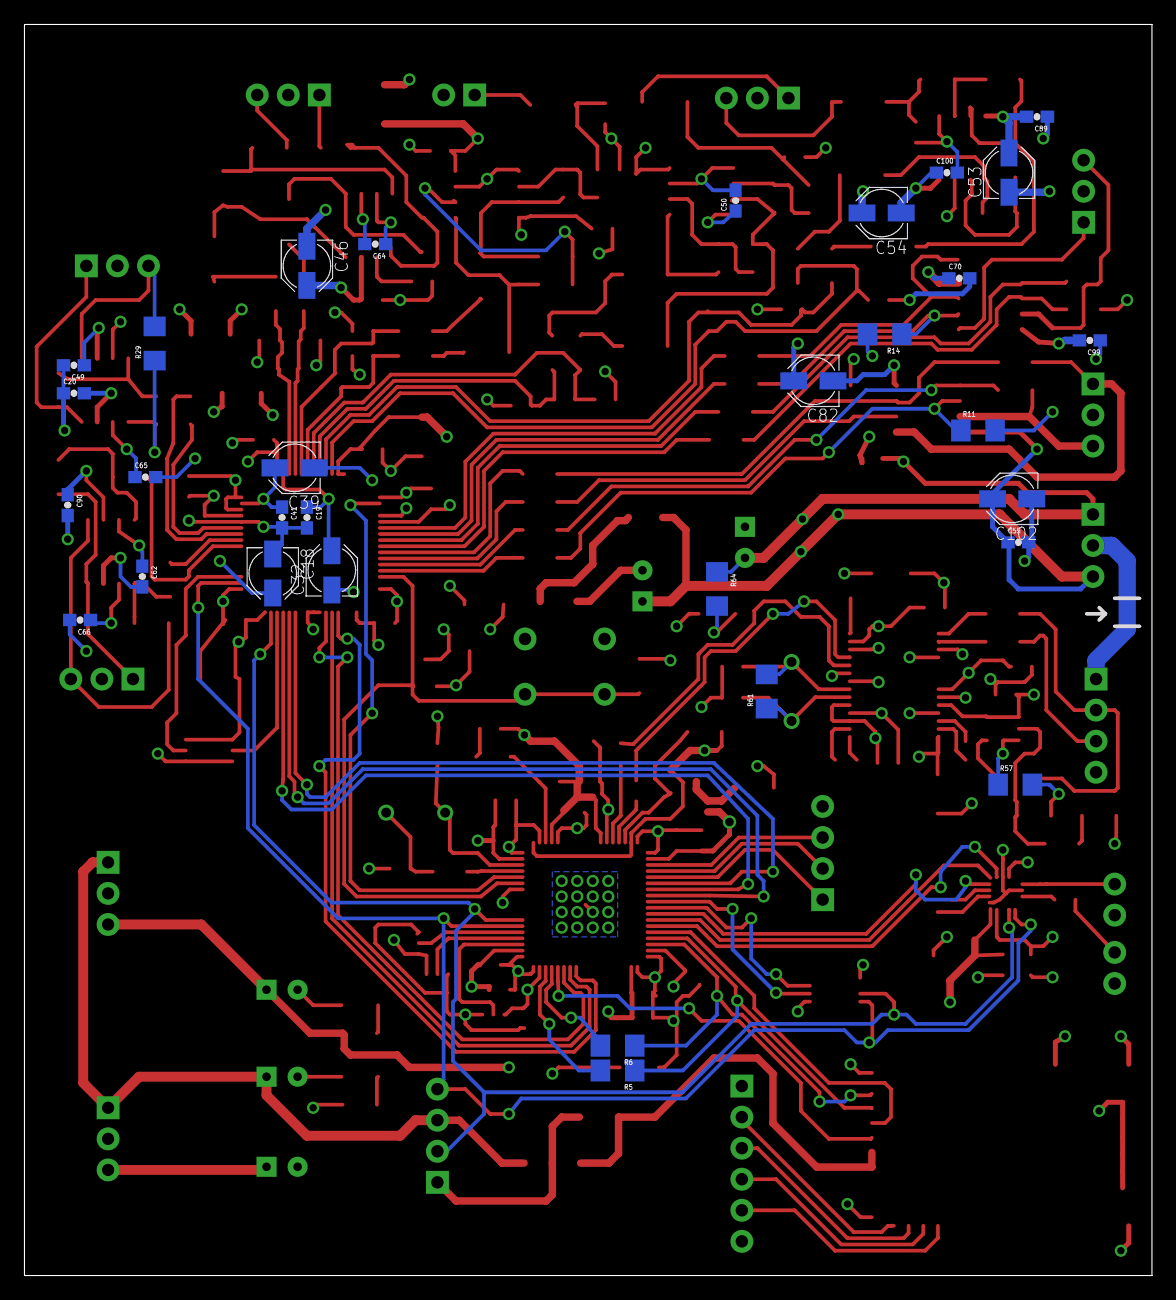
[picture p20: board dsp.brd from below]

Board: 4 copper layers, 92.2 x 102.3 mm, 227 parts (31 on the bottom side), 153 nets.
