tristantech/Dorm-Room-Automation/Boards/Media/distribution.brd

## EAGLE design Boards/Media/distribution.brd (2014-12-10)

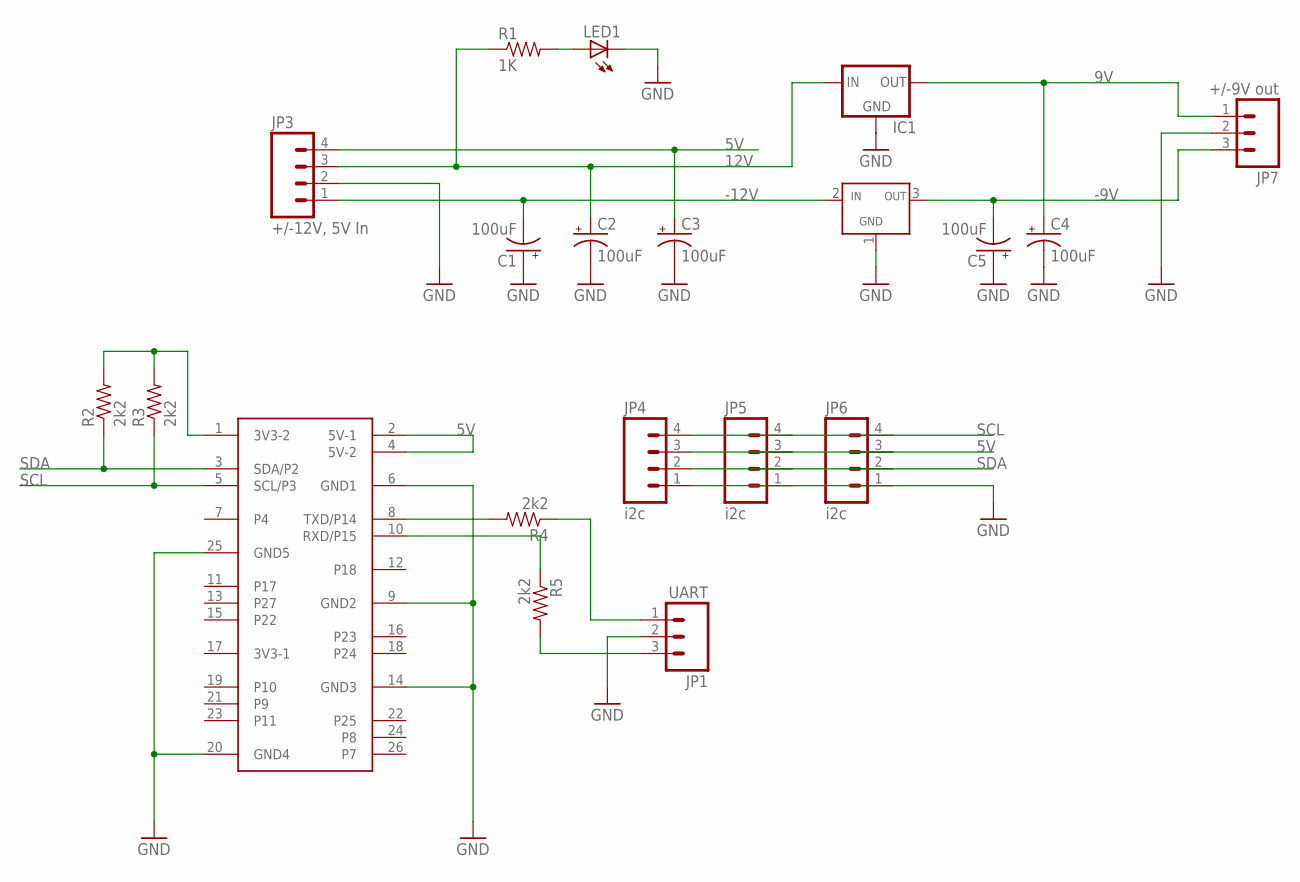
[picture p21: schematic distribution.sch]

Parts:
C1, C2, C3, C4, C5: 100uF; CPOL-RADIAL-100UF-25V
IC1: 78XXS
JP1: UART; MOLEX-1X3
JP3: +/-12V, 5V In; SCREWTERMINAL-3.5MM-4
JP4, JP5, JP6: i2c; MOLEX-1X4
JP7: +/-9V out; MOLEX-1X3
LED1: LED1206; LED-1206
R1: 1K; 1206
R2, R3, R4, R5: 2k2; 1206
U$1: VREG-GIO; TO-220V
U$2: PI-GPIO; M2X13

Connections:
5V: C3.1 (+), JP3.4, JP4.3, JP5.3, JP6.3, U$2.2 (5V-1), U$2.4 (5V-2)
9V: C4.1 (+), IC1.OUT, JP7.1
12V: C2.1 (+), IC1.IN, JP3.3, R1.1
-9V: C5.2 (-), JP7.3, U$1.3 (OUT)
-12V: C1.2 (-), JP3.1, U$1.2 (IN)
GND: C1.1 (+), C2.2 (-), C3.2 (-), C4.2 (-), C5.1 (+), IC1.GND, JP1.2, JP3.2, JP4.1, JP5.1, JP6.1, JP7.2, LED1.C, U$1.1 (GND), U$2.6 (GND1), U$2.9 (GND2), U$2.14 (GND3), U$2.20 (GND4), U$2.25 (GND5)
unnamed: LED1.A, R1.2
unnamed: R2.2, R3.2, U$2.1 (3V3-2)
unnamed: R4.2, U$2.8 (TXD/P14)
unnamed: R5.1, U$2.10 (RXD/P15)
unnamed: JP1.1, R4.1
unnamed: JP1.3, R5.2
SCL: JP4.4, JP5.4, JP6.4, R3.1, U$2.5 (SCL/P3)
SDA: JP4.2, JP5.2, JP6.2, R2.1, U$2.3 (SDA/P2)
