tristantech/Dorm-Room-Automation/Boards/Media/distribution.brd

## EAGLE design Boards/Media/distribution.brd (continued)

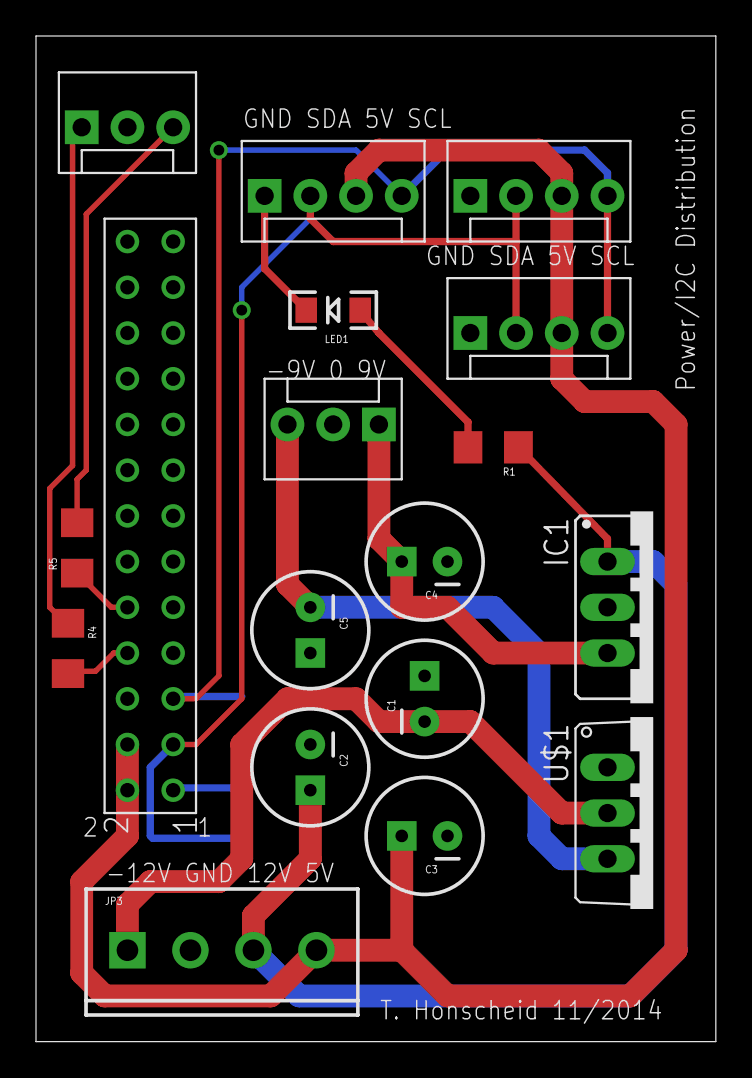
[picture p22: board distribution.brd from above]

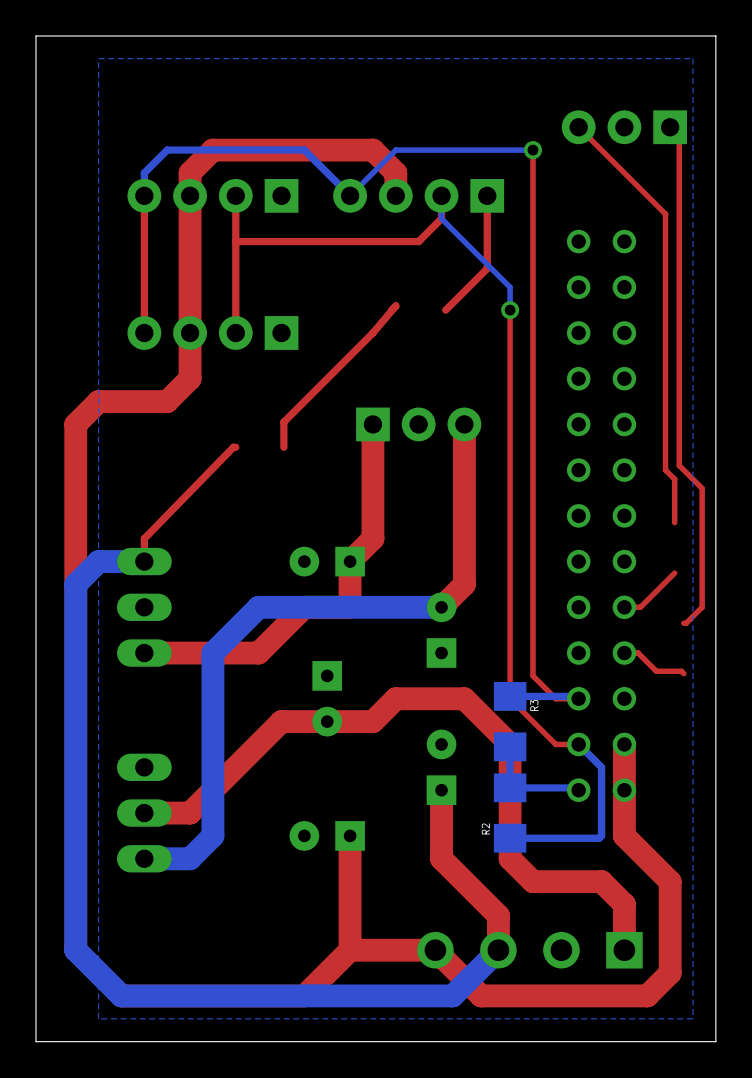
[picture p23: board distribution.brd from below]

Board: 2 copper layers, 37.8 x 55.9 mm, 20 parts (2 on the bottom side), 14 nets.
