tristantech/Dorm-Room-Automation/Boards/Window/Window.brd

## EAGLE design Boards/Window/Window.brd (2014-12-10)

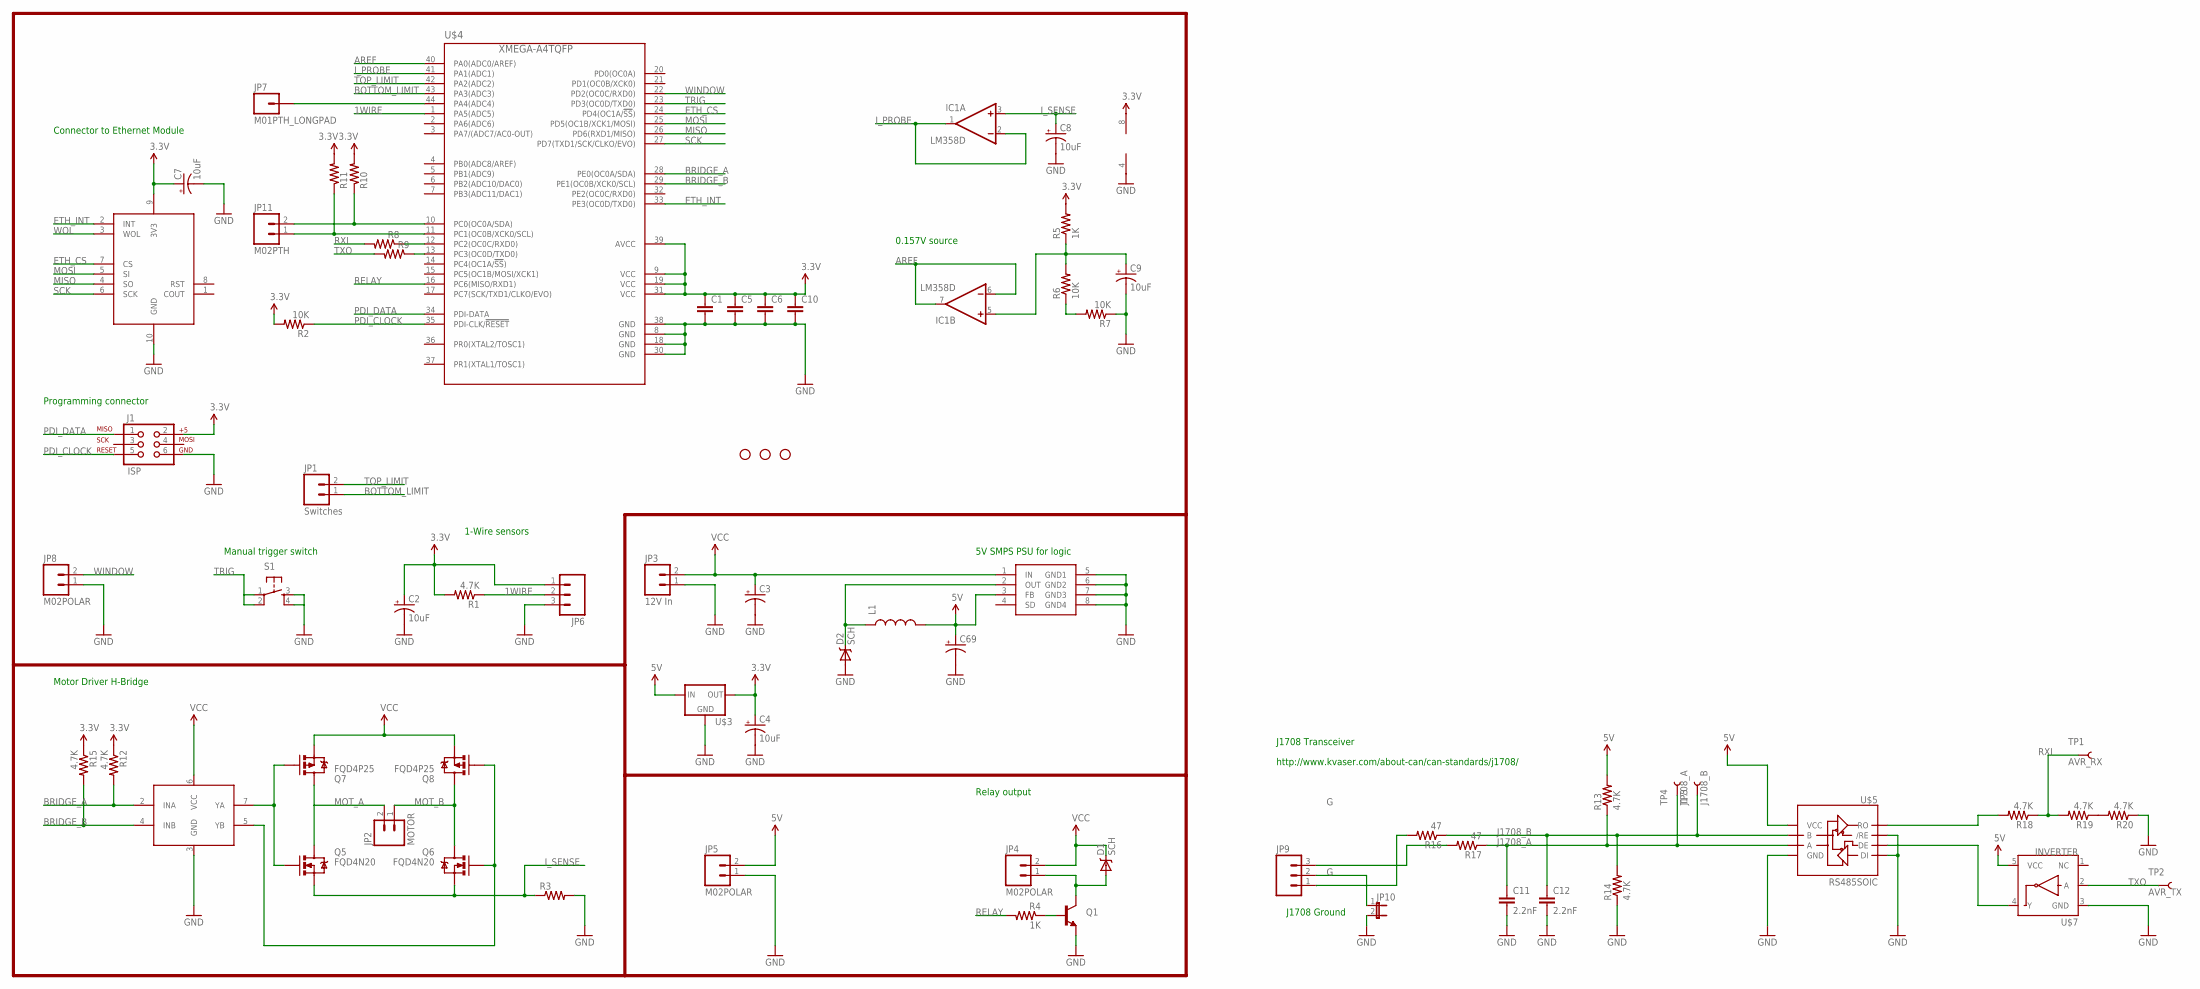
[picture p24: schematic Window.sch]

Parts:
C1, C5, C6, C10: CAP0603-CAP; 0603-CAP
C2, C4, C7, C8, C9: 10uF; EIA3216
C3, C69: CAP_POLPTH1; CPOL-RADIAL-100UF-25V
C11, C12: 2.2nF; 0603-CAP
D1, D2: SCH; SMA-DIODE
IC1: LM358D; SO08
J1: ISP; 2X3
JP1: Switches; SCREWTERMINAL-3.5MM-2
JP2: MOTOR; SCREWTERMINAL-3.5MM-2
JP3: 12V In; SCREWTERMINAL-3.5MM-2
JP4, JP5, JP8: M02POLAR; MOLEX-1X2
JP6, JP9: M03POLAR; MOLEX-1X3
JP7: M01PTH_LONGPAD; 1X01_LONGPAD
JP10: JUMPER-2PTH; 1X02
JP11: M02PTH; 1X02
L1: INDUCTOR1206H*; INDUCTOR-1206
Q1: TRANSISTOR_NPNSOT23; SOT23
Q5, Q6: FQD4N20; DPAK
Q7, Q8: FQD4P25; DPAK
R1, R12, R13, R14, R15, R18, R19, R20: 4.7K; 1206
R2, R6, R7: 10K; 1206
R3: RESISTORPTH-1W; AXIAL-0.6
R4, R5: 1K; 1206
R8, R9, R10, R11: RESISTOR0603-RES; 0603-RES
R16, R17: 47; 1206
S1: TAC_SWITCHPTH; TACTILE-PTH
STANDOFF2, STANDOFF3, STANDOFF4: STAND-OFF
TP1: AVR_RX; PAD.03X.05
TP2: AVR_TX; PAD.03X.05
TP3: J1708_B; PAD.03X.05
TP4: J1708_A; PAD.03X.05
U$1: ETHMODULE; 2X5
U$2: AP1509-33; SOIC-8
U$3: V_REG_MIC2920; SOT223
U$4: XMEGA-A4TQFP; TQFP44
U$5: RS485SOIC; SO08
U$6: 4427; SOIC-8
U$7: INVERTER; SOT23-5

Connections:
1WIRE: JP6.2, R1.1, U$4.1 (PA5(ADC5))
3.3V: C1.1, C2.A (+), C4.A (+), C5.1, C6.1, C7.A (+), C10.1, IC1.8 (V+), J1.2, JP6.1, R1.2, R2.2, R5.2, R10.2, R11.2, R12.1, R15.1, U$1.9 (3V3), U$3.3 (OUT), U$4.9 (VCC), U$4.19 (VCC), U$4.31 (VCC), U$4.39 (AVCC)
5V: C69.1 (+), JP5.2, L1.P$2 (2), R13.2, U$2.3 (FB), U$3.1 (IN), U$5.8 (VCC), U$7.5 (VCC)
AREF: IC1.6 (-IN), IC1.7 (OUT), U$4.40 (PA0(ADC0/AREF))
BOTTOM_LIMIT: JP1.1, U$4.43 (PA3(ADC3))
BRIDGE_A: R12.2, U$4.28 (PE0(OC0A/SDA)), U$6.2 (INA)
BRIDGE_B: R15.2, U$4.29 (PE1(OC0B/XCK0/SCL)), U$6.4 (INB)
COUT: U$1.1 (COUT)
ETH_CS: U$1.7 (CS), U$4.24 (PD4(OC1A/!SS!))
ETH_INT: U$1.2 (INT), U$4.33 (PE3(OC0D/TXD0))
G: JP9.2, JP10.1
GND: C1.2, C2.C (-), C3.2 (-), C4.C (-), C5.2, C6.2, C7.C (-), C8.C (-), C9.C (-), C10.2, C11.2, C12.2, C69.2 (-), D2.A, IC1.4 (V-), J1.6, JP3.1, JP5.1, JP6.3, JP8.1, JP10.2, Q1.2 (E), R3.P$2 (2), R7.1, R14.1, R20.1, S1.3, S1.4, U$1.10 (GND), U$2.5 (GND1), U$2.6 (GND2), U$2.7 (GND3), U$2.8 (GND4), U$3.2 (GND), U$4.8 (GND), U$4.18 (GND), U$4.30 (GND), U$4.38 (GND), U$5.2 (/RE), U$5.4 (DI), U$5.5 (GND), U$6.3 (GND), U$7.3 (GND)
I_PROBE: IC1.1 (OUT), IC1.2 (-IN), U$4.41 (PA1(ADC1))
I_SENSE: C8.A (+), IC1.3 (+IN), Q5.3 (S), Q6.3 (S), R3.P$1 (1)
J1708_A: C11.1, R13.1, R17.1, TP4.P$1, U$5.6 (A)
J1708_B: C12.1, R14.2, R16.1, TP3.P$1, U$5.7 (B)
MISO: U$1.4 (SO), U$4.26 (PD6(RXD1/MISO))
MOSI: U$1.5 (SI), U$4.25 (PD5(OC1B/XCK1/MOSI))
MOT_A: JP2.2, Q5.4 (D), Q7.4 (D)
MOT_B: JP2.1, Q6.4 (D), Q8.4 (D)
unnamed: JP11.2, R10.1, U$4.10 (PC0(OC0A/SDA))
unnamed: JP11.1, R11.1, U$4.11 (PC1(OC0B/XCK0/SCL))
unnamed: D2.C, L1.P$1 (1), U$2.2 (OUT)
unnamed: R8.1, U$4.12 (PC2(OC0C/RXD0))
unnamed: D1.A, JP4.1, Q1.3 (C)
unnamed: JP9.1, R16.2
unnamed: R6.1, R7.2
unnamed: Q5.1 (G), Q7.1 (G), U$6.7 (YA)
unnamed: Q1.1 (B), R4.1
unnamed: C9.A (+), IC1.5 (+IN), R5.1, R6.2
unnamed: R9.1, U$4.13 (PC3(OC0D/TXD0))
unnamed: JP9.3, R17.2
unnamed: R18.2, U$5.1 (RO)
unnamed: R19.1, R20.2
unnamed: Q6.1 (G), Q8.1 (G), U$6.5 (YB)
unnamed: U$5.3 (DE), U$7.4 (Y)
unnamed: JP7.1, U$4.44 (PA4(ADC4))
PDI_CLOCK: J1.5, R2.1, U$4.35 (PDI-CLK/!RESET)
PDI_DATA: J1.1, U$4.34 (PDI-DATA)
RELAY: R4.2, U$4.16 (PC6(MISO/RXD1))
RST: U$1.8 (RST)
RXI: R8.2, R18.1, R19.2, TP1.P$1
SCK: U$1.6 (SCK), U$4.27 (PD7(TXD1/SCK/CLKO/EVO))
TOP_LIMIT: JP1.2, U$4.42 (PA2(ADC2))
TRIG: S1.1, S1.2, U$4.23 (PD3(OC0D/TXD0))
TXO: R9.2, TP2.P$1, U$7.2 (A)
VCC: C3.1 (+), D1.C, JP3.2, JP4.2, Q7.3 (S), Q8.3 (S), U$2.1 (IN), U$6.6 (VCC)
WINDOW: JP8.2, U$4.22 (PD2(OC0C/RXD0))
WOL: U$1.3 (WOL)

Notes on the sheet:
Connector to Ethernet Module
Programming connector
1-Wire sensors
Motor Driver H-Bridge
Manual trigger switch
Relay output
0.157V source
5V SMPS PSU for logic
J1708 Ground
J1708 Transceiver
http://www.kvaser.com/about-can/can-standards/j1708/

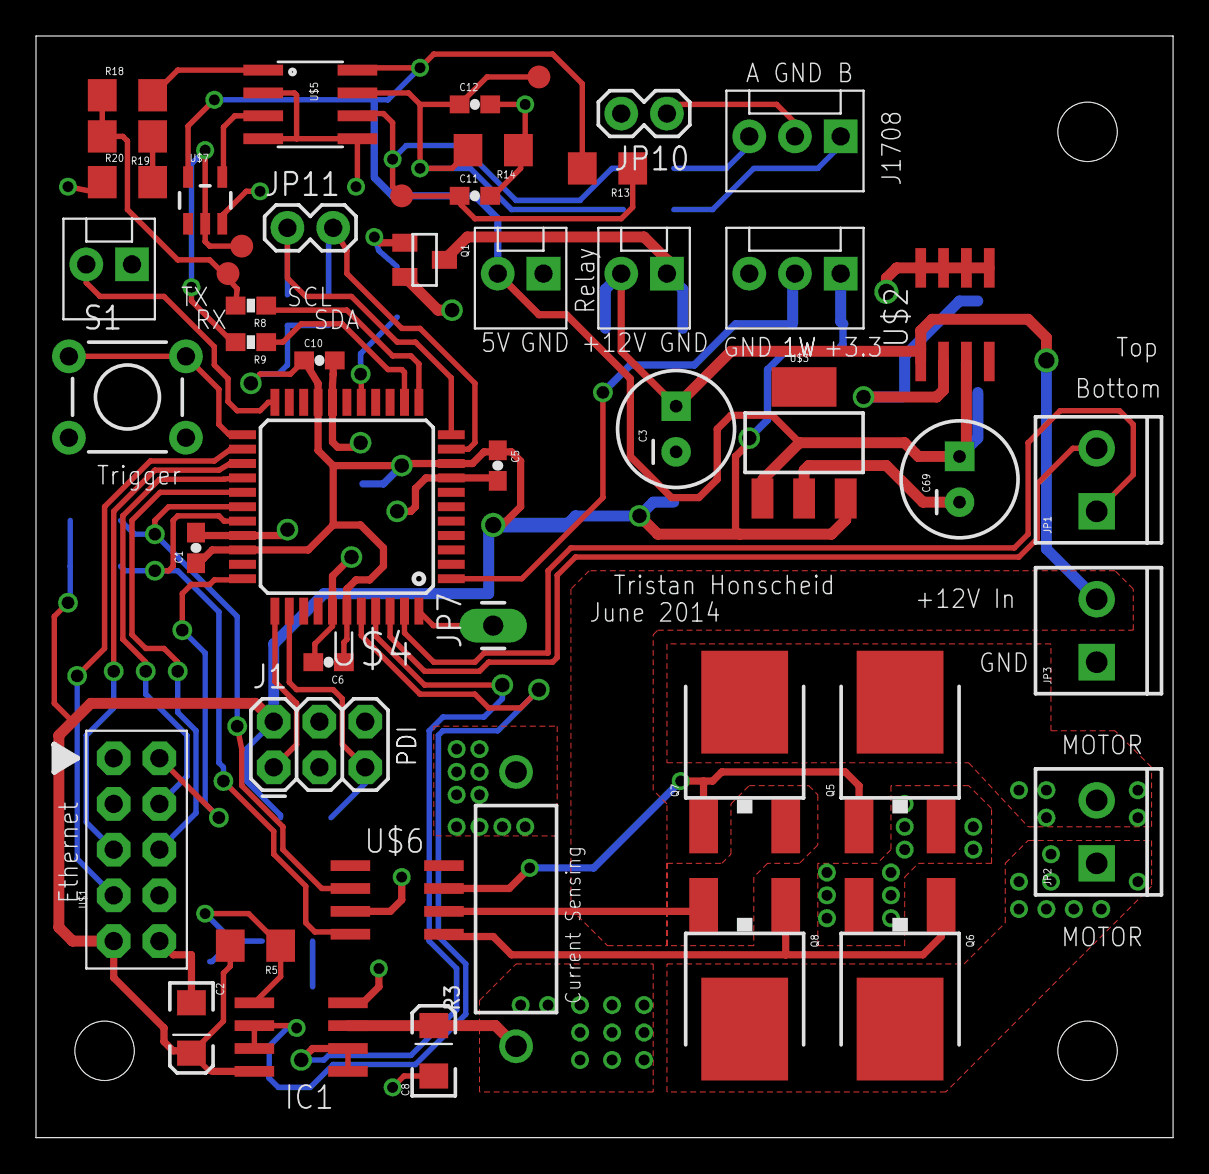
[picture p25: board Window.brd from above]

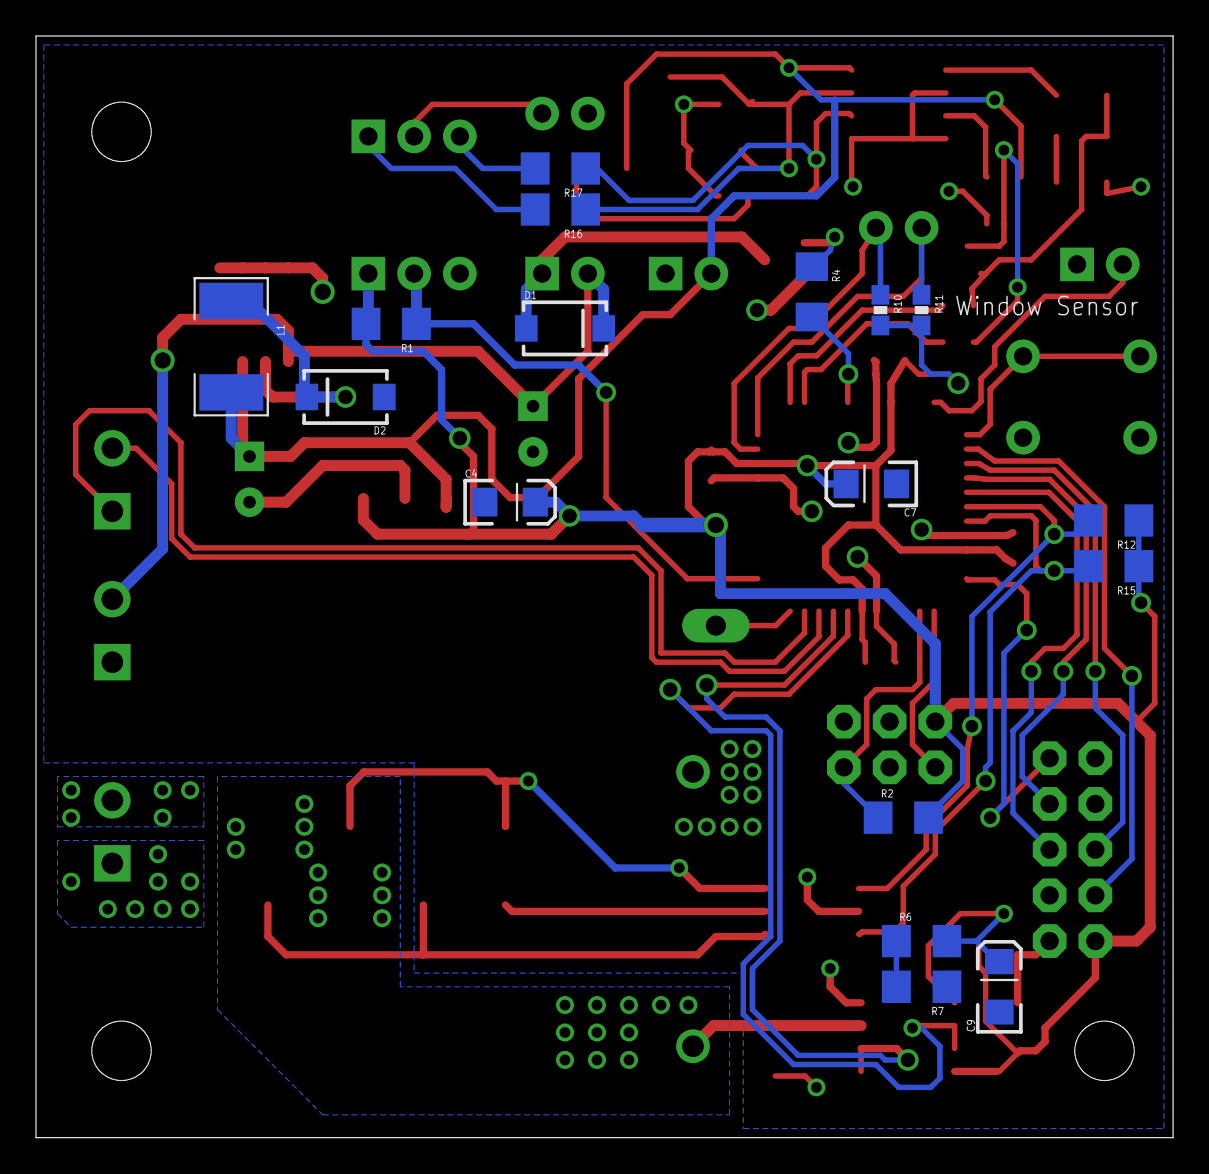
[picture p26: board Window.brd from below]

Board: 2 copper layers, 63.2 x 61.2 mm, 69 parts (17 on the bottom side), 46 nets.
