tristantech/Dorm-Room-Automation/Boards/Lighting/Main.brd

## EAGLE design Boards/Lighting/Main.brd (2014-12-10)

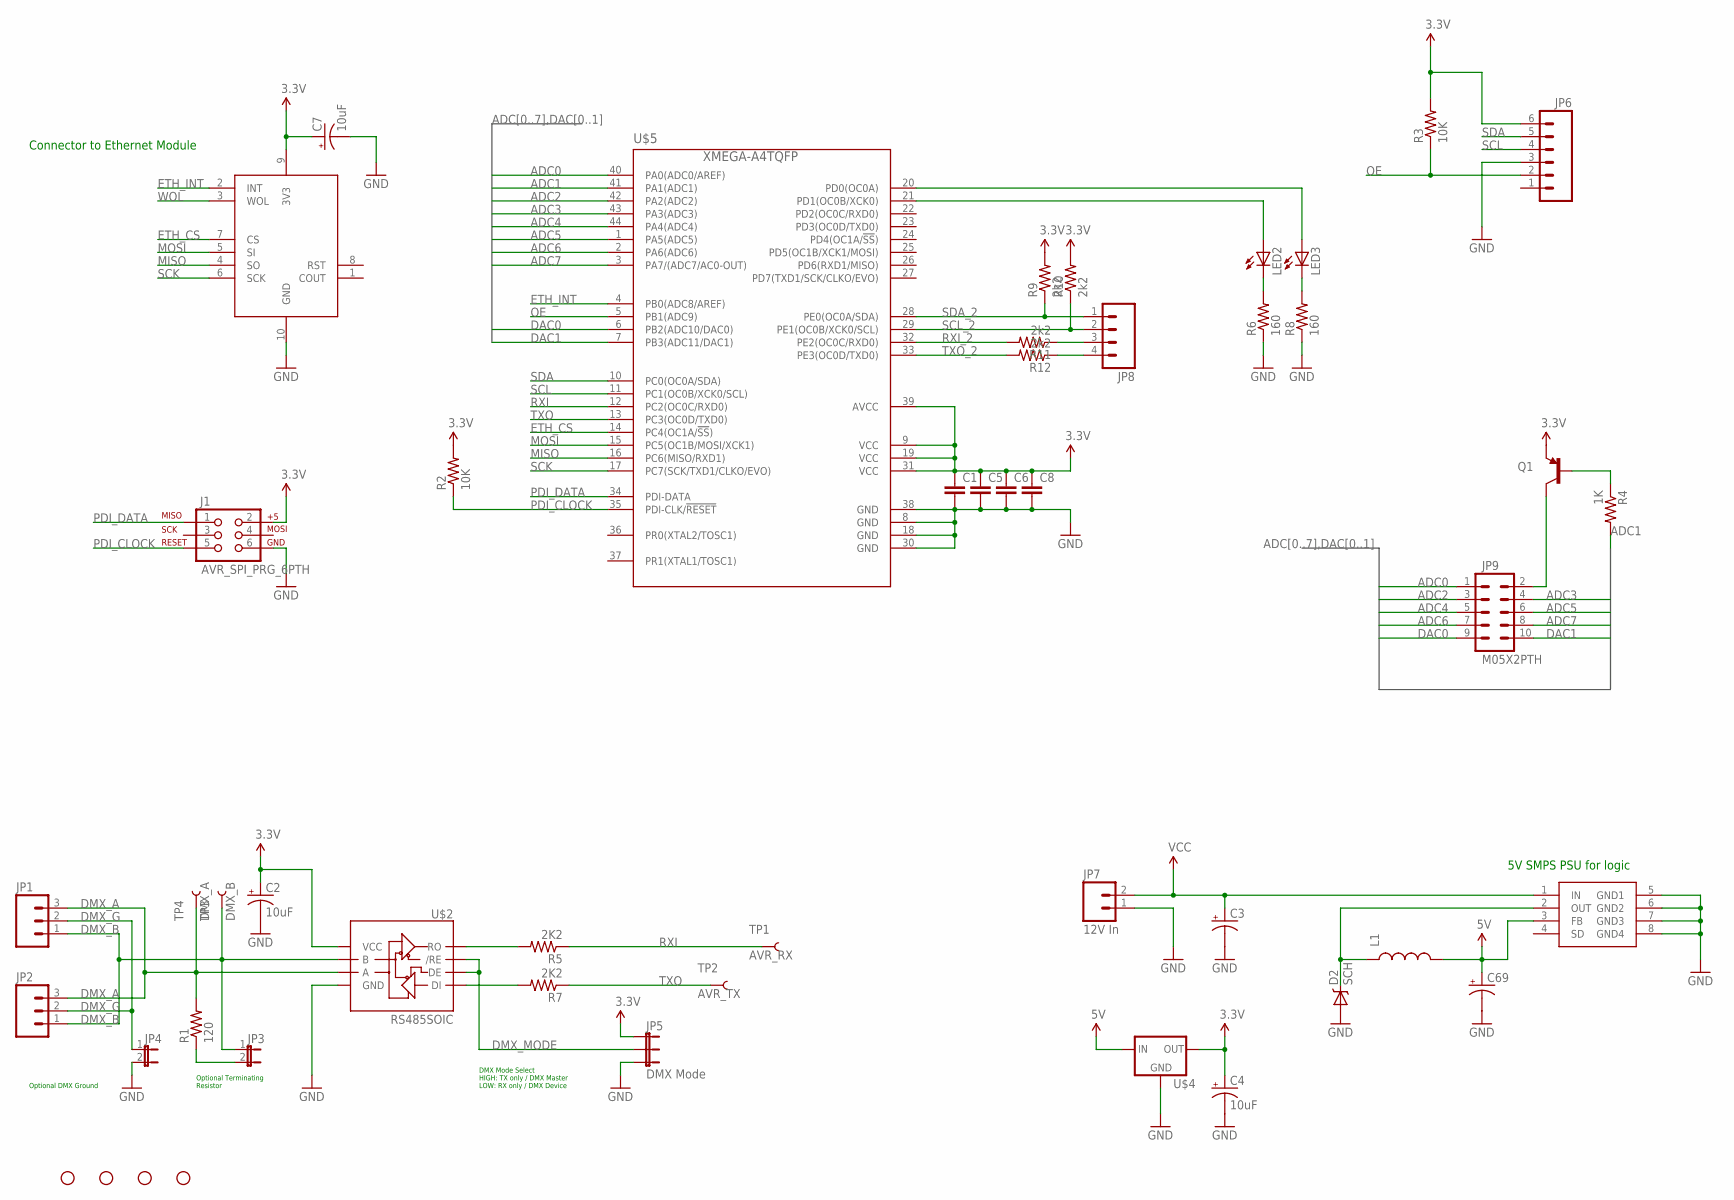
[picture p27: schematic Main.sch]

Parts:
C1, C5, C6, C8: CAP0603-CAP; 0603-CAP
C2, C4, C7: 10uF; EIA3216
C3, C69: CAP_POLPTH1; CPOL-RADIAL-100UF-25V
D2: SCH; SMA-DIODE
J1: AVR_SPI_PRG_6PTH; 2X3
JP1, JP2: M03POLAR; MOLEX-1X3
JP3, JP4: JUMPER-2PTH; 1X02
JP5: DMX Mode; 1X03
JP6: M06POLAR; MOLEX-1X6
JP7: 12V In; SCREWTERMINAL-3.5MM-2
JP8: M04PTH; 1X04
JP9: M05X2PTH; AVR_ICSP
L1: INDUCTOR1206H*; INDUCTOR-1206
LED2, LED3: LED5MM
Q1: TRANSISTOR_PNPSMD; SOT23-3
R1: 120; 1206
R2, R3: 10K; 1206
R4: 1K; 1206
R5, R7: 2K2; 1206
R6, R8: 160; 1206
R9, R10, R11, R12: 2k2; 1206
STANDOFF1, STANDOFF2, STANDOFF3, STANDOFF4: STAND-OFF
TP1: AVR_RX; PAD.03X.05
TP2: AVR_TX; PAD.03X.05
TP3: DMX_B; PAD.03X.05
TP4: DMX_A; PAD.03X.05
U$1: ETHMODULE; 2X5
U$2: RS485SOIC; SO08
U$3: AP1509-33; SOIC-8
U$4: V_REG_MIC2920; SOT223
U$5: XMEGA-A4TQFP; TQFP44

Connections:
3.3V: C1.1, C2.A (+), C4.A (+), C5.1, C6.1, C7.A (+), C8.1, J1.2, JP5.1, JP6.6, Q1.2 (E), R2.2, R3.2, R9.2, R10.2, U$1.9 (3V3), U$2.8 (VCC), U$4.3 (OUT), U$5.9 (VCC), U$5.19 (VCC), U$5.31 (VCC), U$5.39 (AVCC)
5V: C69.1 (+), L1.P$2 (2), U$3.3 (FB), U$4.1 (IN)
ADC0: JP9.1, U$5.40 (PA0(ADC0/AREF))
ADC1: R4.2, U$5.41 (PA1(ADC1))
ADC2: JP9.3, U$5.42 (PA2(ADC2))
ADC3: JP9.4, U$5.43 (PA3(ADC3))
ADC4: JP9.5, U$5.44 (PA4(ADC4))
ADC5: JP9.6, U$5.1 (PA5(ADC5))
ADC6: JP9.7, U$5.2 (PA6(ADC6))
ADC7: JP9.8, U$5.3 (PA7/(ADC7/AC0-OUT))
COUT: U$1.1 (COUT)
DAC0: JP9.9, U$5.6 (PB2(ADC10/DAC0))
DAC1: JP9.10, U$5.7 (PB3(ADC11/DAC1))
DMX_A: JP1.3, JP2.3, R1.2, TP4.P$1, U$2.6 (A)
DMX_B: JP1.1, JP2.1, JP3.1, TP3.P$1, U$2.7 (B)
DMX_G: JP1.2, JP2.2, JP4.1
DMX_MODE: JP5.2, U$2.2 (/RE), U$2.3 (DE)
ETH_CS: U$1.7 (CS), U$5.14 (PC4(OC1A/!SS!))
ETH_INT: U$1.2 (INT), U$5.4 (PB0(ADC8/AREF))
GND: C1.2, C2.C (-), C3.2 (-), C4.C (-), C5.2, C6.2, C7.C (-), C8.2, C69.2 (-), D2.A, J1.6, JP4.2, JP5.3, JP6.3, JP7.1, R6.1, R8.1, U$1.10 (GND), U$2.5 (GND), U$3.5 (GND1), U$3.6 (GND2), U$3.7 (GND3), U$3.8 (GND4), U$4.2 (GND), U$5.8 (GND), U$5.18 (GND), U$5.30 (GND), U$5.38 (GND)
MISO: U$1.4 (SO), U$5.16 (PC6(MISO/RXD1))
MOSI: U$1.5 (SI), U$5.15 (PC5(OC1B/MOSI/XCK1))
unnamed: D2.C, L1.P$1 (1), U$3.2 (OUT)
unnamed: JP8.3, R11.1
unnamed: R7.2, U$2.4 (DI)
unnamed: R5.2, U$2.1 (RO)
unnamed: LED3.A, U$5.20 (PD0(OC0A))
unnamed: LED2.A, U$5.21 (PD1(OC0B/XCK0))
unnamed: JP9.2, Q1.3 (C)
unnamed: JP3.2, R1.1
unnamed: Q1.1 (B), R4.1
unnamed: LED2.K (C), R6.2
unnamed: LED3.K (C), R8.2
unnamed: JP8.4, R12.1
OE: JP6.2, R3.1, U$5.5 (PB1(ADC9))
PDI_CLOCK: J1.5, R2.1, U$5.35 (PDI-CLK/!RESET)
PDI_DATA: J1.1, U$5.34 (PDI-DATA)
RST: U$1.8 (RST)
RXI: R5.1, TP1.P$1, U$5.12 (PC2(OC0C/RXD0))
RXI_2: R11.2, U$5.32 (PE2(OC0C/RXD0))
SCK: U$1.6 (SCK), U$5.17 (PC7(SCK/TXD1/CLKO/EVO))
SCL: JP6.4, U$5.11 (PC1(OC0B/XCK0/SCL))
SCL_2: JP8.2, R10.1, U$5.29 (PE1(OC0B/XCK0/SCL))
SDA: JP6.5, U$5.10 (PC0(OC0A/SDA))
SDA_2: JP8.1, R9.1, U$5.28 (PE0(OC0A/SDA))
TXO: R7.1, TP2.P$1, U$5.13 (PC3(OC0D/TXD0))
TXO_2: R12.2, U$5.33 (PE3(OC0D/TXD0))
VCC: C3.1 (+), JP7.2, U$3.1 (IN)
WOL: U$1.3 (WOL)

Notes on the sheet:
Optional Terminating Resistor
Optional DMX Ground
DMX Mode Select HIGH: TX only / DMX Master LOW: RX only / DMX Device
Connector to Ethernet Module
5V SMPS PSU for logic

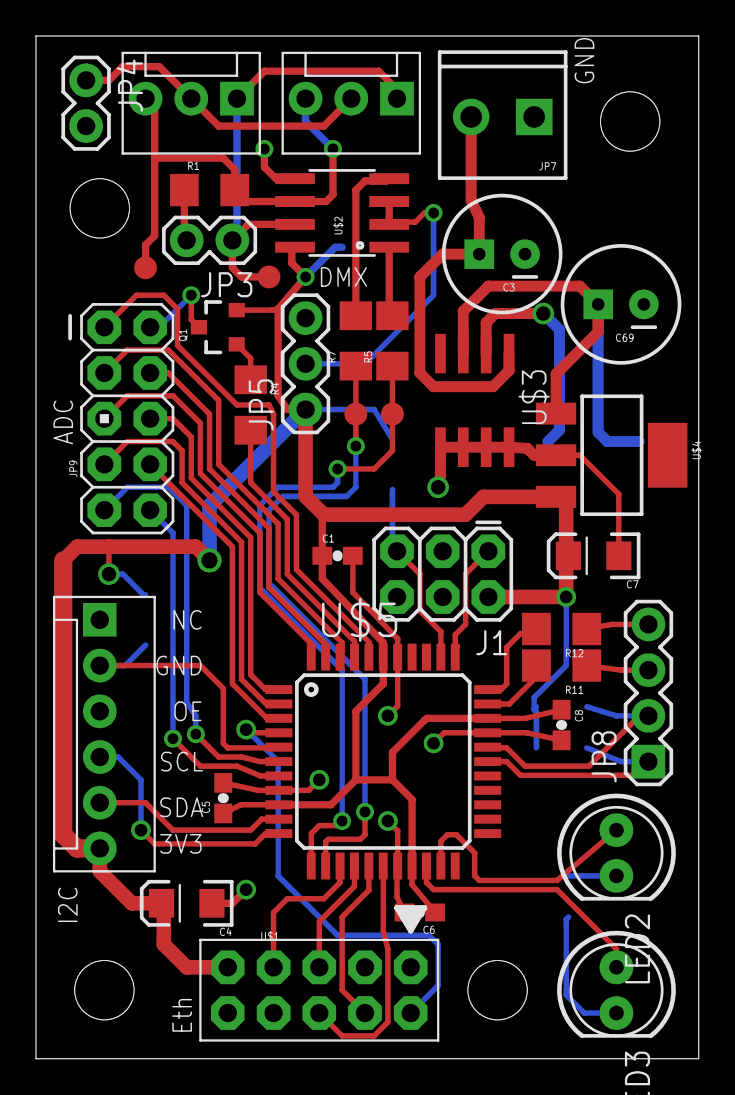
[picture p28: board Main.brd from above]

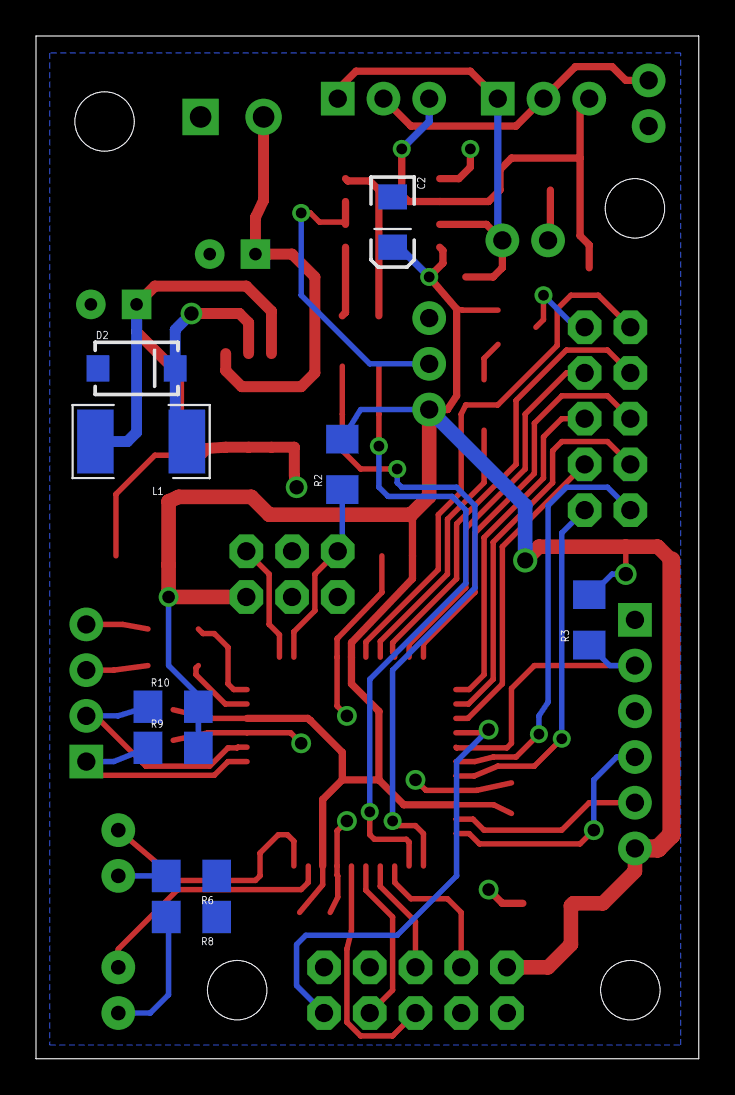
[picture p29: board Main.brd from below]

Board: 2 copper layers, 36.8 x 56.8 mm, 49 parts (9 on the bottom side), 46 nets.
