tristantech/Dorm-Room-Automation/Boards/Lighting/PWM_Board.brd

## EAGLE design Boards/Lighting/PWM_Board.brd (2014-12-10)

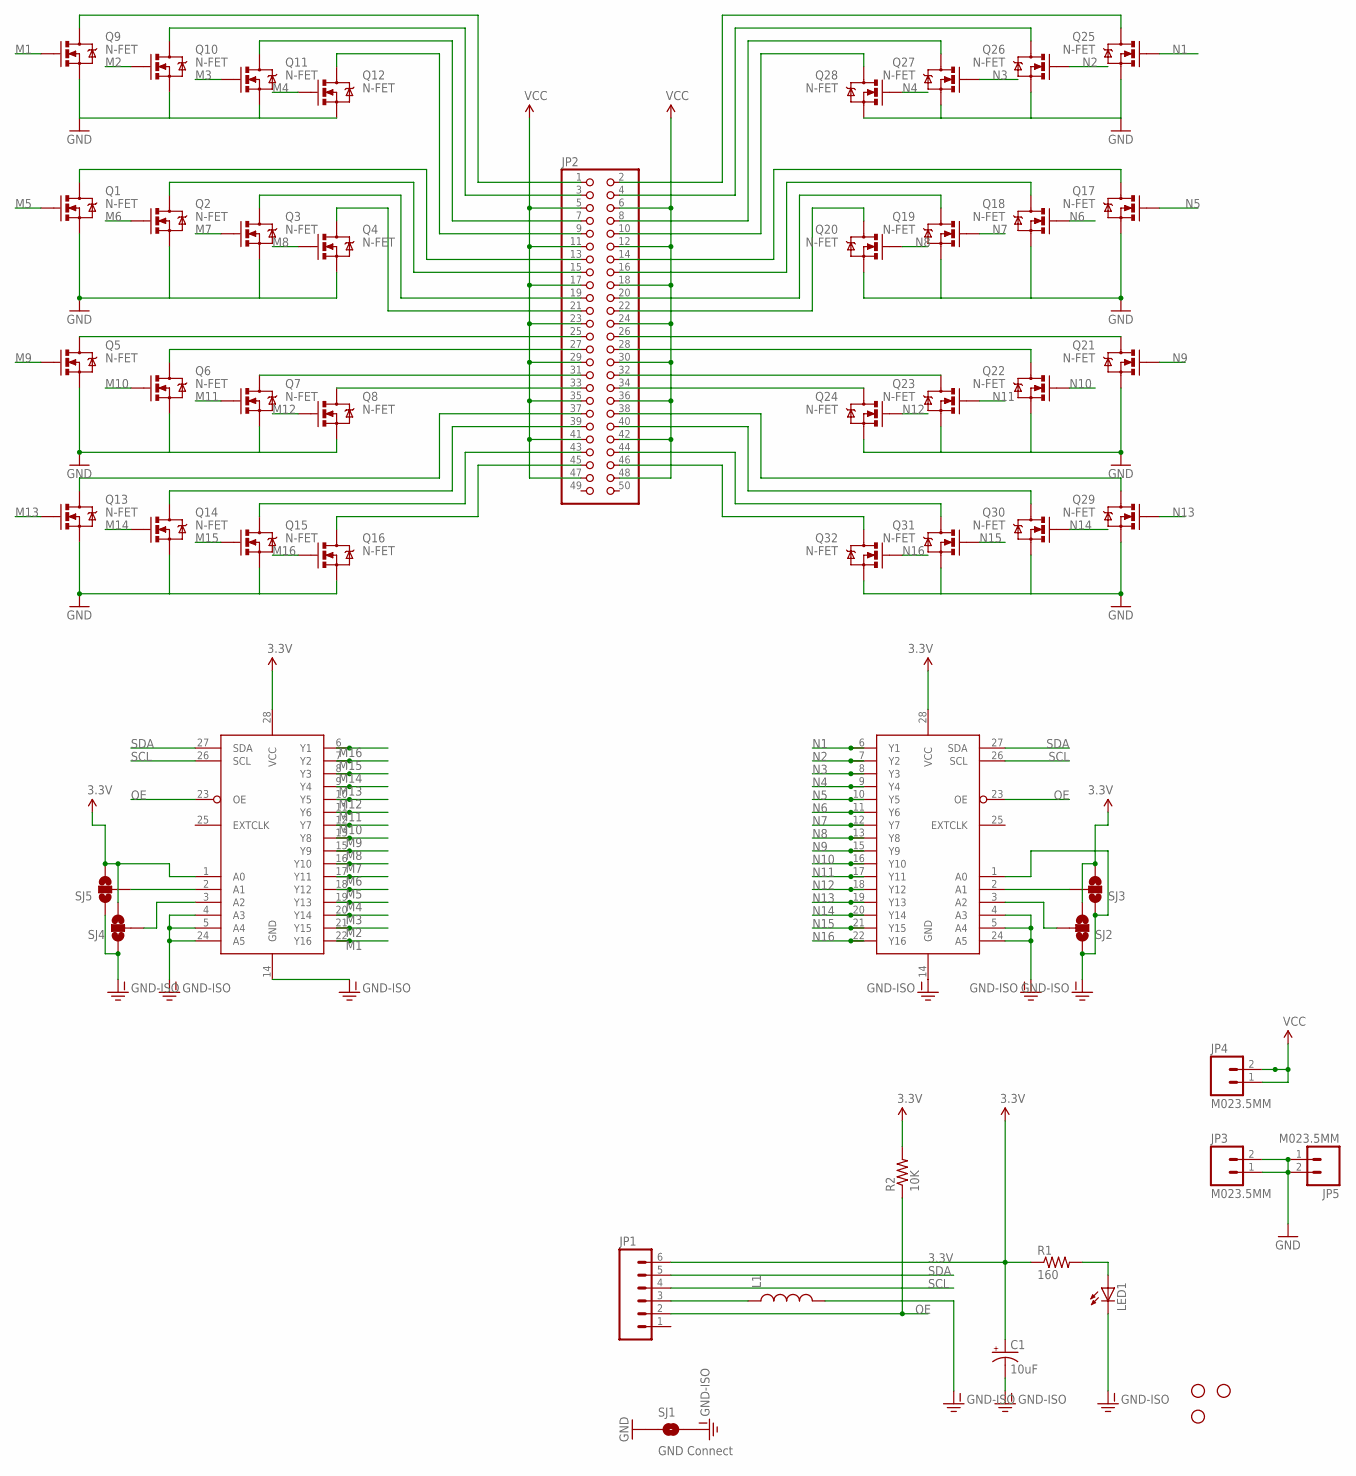
[picture p30: schematic PWM_Board.sch]

Parts:
C1: 10uF; EIA3216
JP1: M06POLAR; MOLEX-1X6
JP2: PINHD-2X25; 2X25
JP3, JP4, JP5: M023.5MM; SCREWTERMINAL-3.5MM-2
L1: INDUCTOR1206H*; INDUCTOR-1206
LED1: LED-FKIT-1206; FKIT-LED-1206
Q1, Q2, Q3, Q4, Q5, Q6, Q7, Q8, Q9, Q10, Q11, Q12, Q13, Q14, Q15, Q16, Q17, Q18, Q19, Q20, Q21, Q22, Q23, Q24, Q25, Q26, Q27, Q28, Q29, Q30, Q31, Q32: N-FET; SOT23
R1: 160; 1206
R2: 10K; 1206
SJ1: GND Connect; SJ_2S
SJ2, SJ3, SJ4, SJ5: SOLDERJUMPER_2WAYS; SJ_3
STANDOFF1, STANDOFF3, STANDOFF4: STAND-OFF
U$2, U$3: PCA9685; TSSOP28

Connections:
3.3V: C1.A (+), JP1.6, R1.1, R2.2, SJ2.3, SJ3.3, SJ4.3, SJ5.3, U$2.28 (VCC), U$3.1 (A0), U$3.28 (VCC)
GND: JP3.1, JP3.2, JP5.1, JP5.2, Q1.2 (S), Q2.2 (S), Q3.2 (S), Q4.2 (S), Q5.2 (S), Q6.2 (S), Q7.2 (S), Q8.2 (S), Q9.2 (S), Q10.2 (S), Q11.2 (S), Q12.2 (S), Q13.2 (S), Q14.2 (S), Q15.2 (S), Q16.2 (S), Q17.2 (S), Q18.2 (S), Q19.2 (S), Q20.2 (S), Q21.2 (S), Q22.2 (S), Q23.2 (S), Q24.2 (S), Q25.2 (S), Q26.2 (S), Q27.2 (S), Q28.2 (S), Q29.2 (S), Q30.2 (S), Q31.2 (S), Q32.2 (S), SJ1.1
GND-ISO: C1.C (-), L1.P$2 (2), LED1.C, SJ1.2, SJ2.1, SJ3.1, SJ4.1, SJ5.1, U$2.1 (A0), U$2.4 (A3), U$2.5 (A4), U$2.14 (GND), U$2.24 (A5), U$3.4 (A3), U$3.5 (A4), U$3.14 (GND), U$3.24 (A5)
M1: Q9.1 (G), U$3.22 (Y16)
M2: Q10.1 (G), U$3.21 (Y15)
M3: Q11.1 (G), U$3.20 (Y14)
M4: Q12.1 (G), U$3.19 (Y13)
M5: Q1.1 (G), U$3.18 (Y12)
M6: Q2.1 (G), U$3.17 (Y11)
M7: Q3.1 (G), U$3.16 (Y10)
M8: Q4.1 (G), U$3.15 (Y9)
M9: Q5.1 (G), U$3.13 (Y8)
M10: Q6.1 (G), U$3.12 (Y7)
M11: Q7.1 (G), U$3.11 (Y6)
M12: Q8.1 (G), U$3.10 (Y5)
M13: Q13.1 (G), U$3.9 (Y4)
M14: Q14.1 (G), U$3.8 (Y3)
M15: Q15.1 (G), U$3.7 (Y2)
M16: Q16.1 (G), U$3.6 (Y1)
N1: Q25.1 (G), U$2.6 (Y1)
N2: Q26.1 (G), U$2.7 (Y2)
N3: Q27.1 (G), U$2.8 (Y3)
N4: Q28.1 (G), U$2.9 (Y4)
N5: Q17.1 (G), U$2.10 (Y5)
N6: Q18.1 (G), U$2.11 (Y6)
N7: Q19.1 (G), U$2.12 (Y7)
N8: Q20.1 (G), U$2.13 (Y8)
N9: Q21.1 (G), U$2.15 (Y9)
N10: Q22.1 (G), U$2.16 (Y10)
N11: Q23.1 (G), U$2.17 (Y11)
N12: Q24.1 (G), U$2.18 (Y12)
N13: Q29.1 (G), U$2.19 (Y13)
N14: Q30.1 (G), U$2.20 (Y14)
N15: Q31.1 (G), U$2.21 (Y15)
N16: Q32.1 (G), U$2.22 (Y16)
unnamed: JP1.3, L1.P$1 (1)
unnamed: JP2.1, Q9.3 (D)
unnamed: JP2.3, Q10.3 (D)
unnamed: JP2.7, Q11.3 (D)
unnamed: JP2.9, Q12.3 (D)
unnamed: JP2.13, Q1.3 (D)
unnamed: JP2.15, Q2.3 (D)
unnamed: JP2.19, Q3.3 (D)
unnamed: JP2.21, Q4.3 (D)
unnamed: JP2.25, Q5.3 (D)
unnamed: LED1.A, R1.2
unnamed: JP2.27, Q6.3 (D)
unnamed: JP2.31, Q7.3 (D)
unnamed: JP2.33, Q8.3 (D)
unnamed: JP2.37, Q13.3 (D)
unnamed: JP2.39, Q14.3 (D)
unnamed: JP2.43, Q15.3 (D)
unnamed: JP2.45, Q16.3 (D)
unnamed: JP2.2, Q25.3 (D)
unnamed: JP2.4, Q26.3 (D)
unnamed: JP2.8, Q27.3 (D)
unnamed: JP2.10, Q28.3 (D)
unnamed: JP2.14, Q17.3 (D)
unnamed: JP2.16, Q18.3 (D)
unnamed: JP2.20, Q19.3 (D)
unnamed: JP2.22, Q20.3 (D)
unnamed: JP2.26, Q21.3 (D)
unnamed: JP2.28, Q22.3 (D)
unnamed: JP2.32, Q23.3 (D)
unnamed: JP2.34, Q24.3 (D)
unnamed: JP2.38, Q29.3 (D)
unnamed: JP2.40, Q30.3 (D)
unnamed: JP2.44, Q31.3 (D)
unnamed: JP2.46, Q32.3 (D)
unnamed: SJ3.2, U$2.2 (A1)
unnamed: SJ2.2, U$2.3 (A2)
unnamed: SJ5.2, U$3.2 (A1)
unnamed: SJ4.2, U$3.3 (A2)
OE: JP1.2, R2.1, U$2.23 (OE), U$3.23 (OE)
SCL: JP1.4, U$2.26 (SCL), U$3.26 (SCL)
SDA: JP1.5, U$2.27 (SDA), U$3.27 (SDA)
VCC: JP2.5, JP2.6, JP2.11, JP2.12, JP2.17, JP2.18, JP2.23, JP2.24, JP2.29, JP2.30, JP2.35, JP2.36, JP2.41, JP2.42, JP2.47, JP2.48, JP4.1, JP4.2

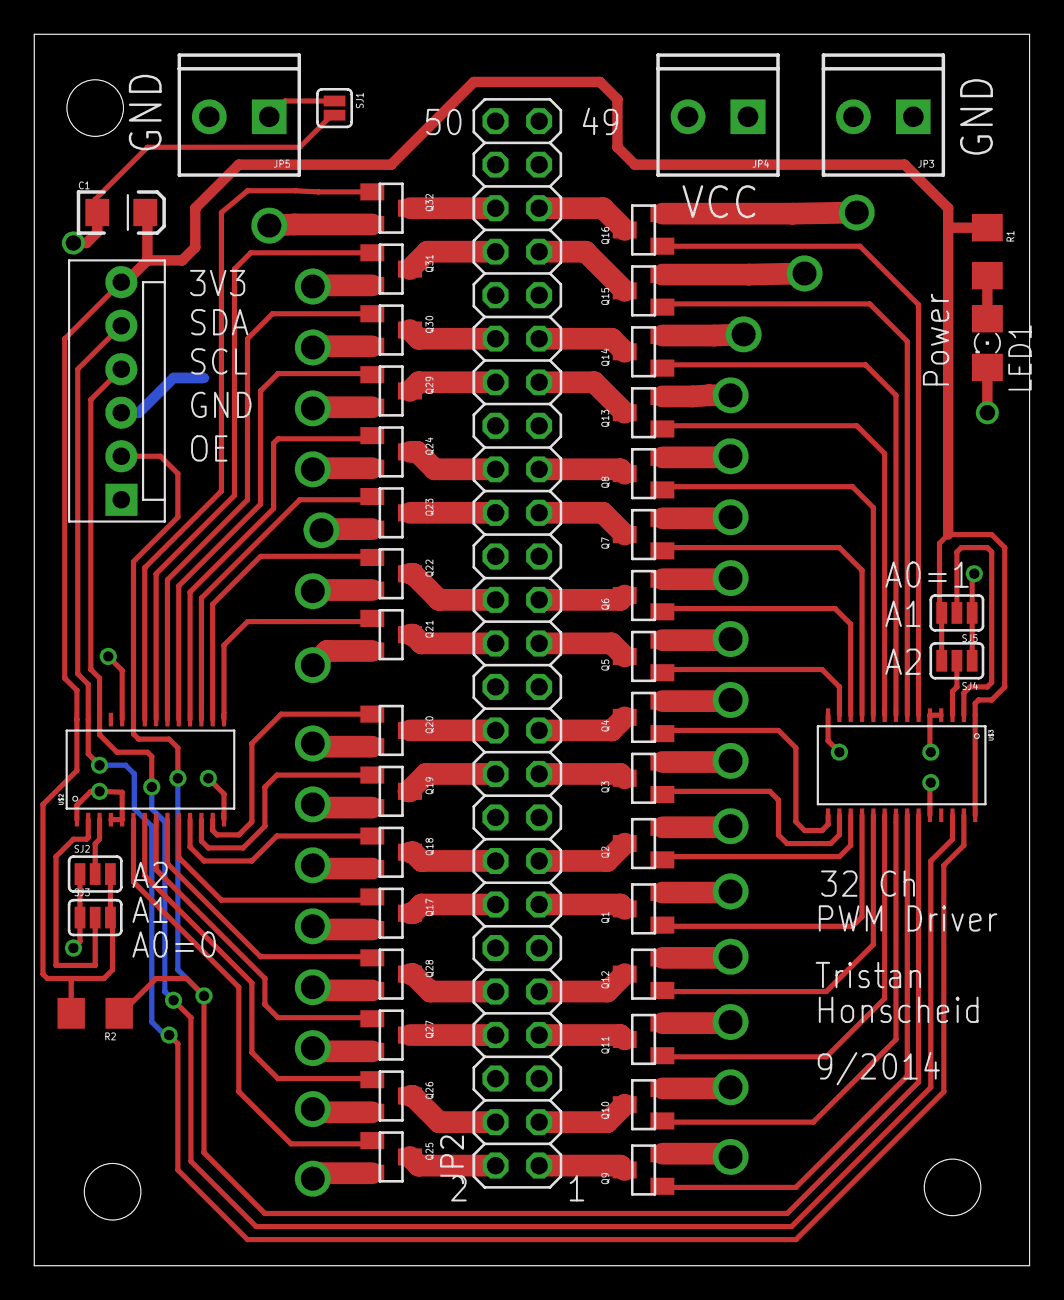
[picture p31: board PWM_Board.brd from above]

Board: 2 copper layers, 58.1 x 71.9 mm, 52 parts (1 on the bottom side), 77 nets.
