tristantech/Dorm-Room-Automation/Boards/Security/Opener.brd

## EAGLE design Boards/Security/Opener.brd (2014-12-10)

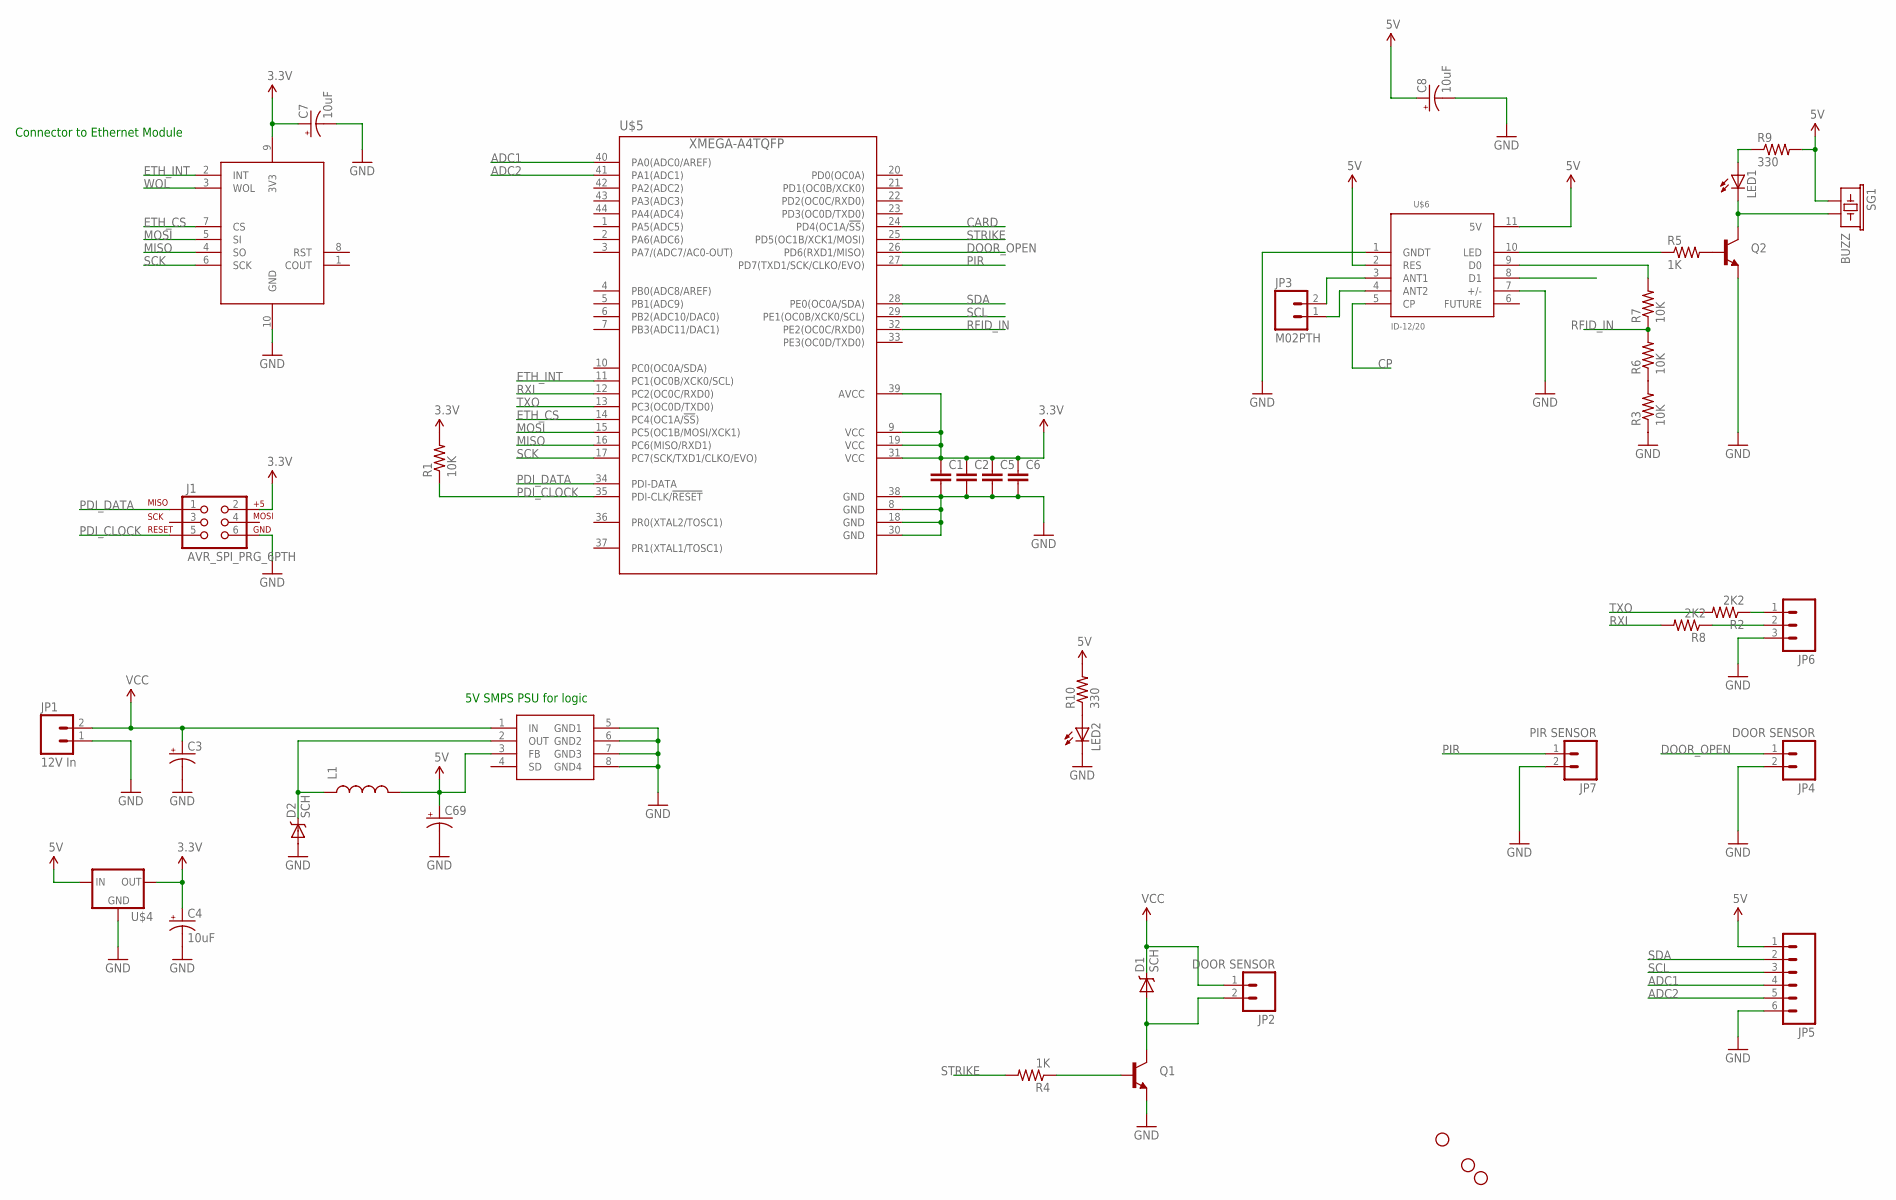
[picture p32: schematic Opener.sch]

Parts:
C1, C2, C5, C6: CAP0603-CAP; 0603-CAP
C3, C69: CAP_POLPTH1; CPOL-RADIAL-100UF-25V
C4, C7, C8: 10uF; EIA3216
D1, D2: SCH; SMA-DIODE
J1: AVR_SPI_PRG_6PTH; 2X3
JP1: 12V In; SCREWTERMINAL-3.5MM-2
JP2, JP4: DOOR SENSOR; MOLEX-1X2
JP3: M02PTH; 1X02
JP5: M06SIP; 1X06
JP6: M03PTH; 1X03
JP7: PIR SENSOR; MOLEX-1X2
L1: INDUCTOR1206H*; INDUCTOR-1206
LED1, LED2: LED-FKIT-1206; FKIT-LED-1206
Q1: TRANSISTOR_NPNTO92; TO-92
Q2: TRANSISTOR_NPNSOT23; SOT23
R1, R3, R6, R7: 10K; 1206
R2, R8: 2K2; 1206
R4, R5: 1K; 1206
R9, R10: 330; 1206
SG1: BUZZ; BUZZER-CCV
STANDOFF1, STANDOFF3, STANDOFF4: STAND-OFF
U$1: ETHMODULE; 2X5
U$3: AP1509-33; SOIC-8
U$4: V_REG_MIC2920; SOT223
U$5: XMEGA-A4TQFP; TQFP44
U$6: ID-12/20; ID-12

Connections:
3.3V: C1.1, C2.1, C4.A (+), C5.1, C6.1, C7.A (+), J1.2, R1.2, U$1.9 (3V3), U$4.3 (OUT), U$5.9 (VCC), U$5.19 (VCC), U$5.31 (VCC), U$5.39 (AVCC)
5V: C8.A (+), C69.1 (+), JP5.1, L1.P$2 (2), R9.2, R10.2, SG1.+ (1), U$3.3 (FB), U$4.1 (IN), U$6.2 (RES), U$6.11 (5V)
ADC1: JP5.4, U$5.40 (PA0(ADC0/AREF))
ADC2: JP5.5, U$5.41 (PA1(ADC1))
CARD: U$5.24 (PD4(OC1A/!SS!))
COUT: U$1.1 (COUT)
CP: U$6.5 (CP)
DOOR_OPEN: JP4.1, U$5.26 (PD6(RXD1/MISO))
ETH_CS: U$1.7 (CS), U$5.14 (PC4(OC1A/!SS!))
ETH_INT: U$1.2 (INT), U$5.11 (PC1(OC0B/XCK0/SCL))
GND: C1.2, C2.2, C3.2 (-), C4.C (-), C5.2, C6.2, C7.C (-), C8.C (-), C69.2 (-), D2.A, J1.6, JP1.1, JP4.2, JP5.6, JP6.3, JP7.2, LED2.C, Q1.1 (E), Q2.2 (E), R3.1, U$1.10 (GND), U$3.5 (GND1), U$3.6 (GND2), U$3.7 (GND3), U$3.8 (GND4), U$4.2 (GND), U$5.8 (GND), U$5.18 (GND), U$5.30 (GND), U$5.38 (GND), U$6.1 (GNDT), U$6.7 (+/-)
MISO: U$1.4 (SO), U$5.16 (PC6(MISO/RXD1))
MOSI: U$1.5 (SI), U$5.15 (PC5(OC1B/MOSI/XCK1))
unnamed: Q1.2 (B), R4.1
unnamed: JP3.2, U$6.3 (ANT1)
unnamed: D2.C, L1.P$1 (1), U$3.2 (OUT)
unnamed: R7.2, U$6.9 (D0)
unnamed: R3.2, R6.1
unnamed: JP3.1, U$6.4 (ANT2)
unnamed: D1.A, JP2.2, Q1.3 (C)
unnamed: R5.1, U$6.10 (LED)
unnamed: Q2.1 (B), R5.2
unnamed: LED1.C, Q2.3 (C), SG1.- (2)
unnamed: LED1.A, R9.1
unnamed: JP6.1, R2.1
unnamed: LED2.A, R10.1
unnamed: JP6.2, R8.1
PDI_CLOCK: J1.5, R1.1, U$5.35 (PDI-CLK/!RESET)
PDI_DATA: J1.1, U$5.34 (PDI-DATA)
PIR: JP7.1, U$5.27 (PD7(TXD1/SCK/CLKO/EVO))
RFID_IN: R6.2, R7.1, U$5.32 (PE2(OC0C/RXD0))
RST: U$1.8 (RST)
RXI: R8.2, U$5.12 (PC2(OC0C/RXD0))
SCK: U$1.6 (SCK), U$5.17 (PC7(SCK/TXD1/CLKO/EVO))
SCL: JP5.3, U$5.29 (PE1(OC0B/XCK0/SCL))
SDA: JP5.2, U$5.28 (PE0(OC0A/SDA))
STRIKE: R4.2, U$5.25 (PD5(OC1B/XCK1/MOSI))
TXO: R2.2, U$5.13 (PC3(OC0D/TXD0))
VCC: C3.1 (+), D1.C, JP1.2, JP2.1, U$3.1 (IN)
WOL: U$1.3 (WOL)

Notes on the sheet:
Connector to Ethernet Module
5V SMPS PSU for logic

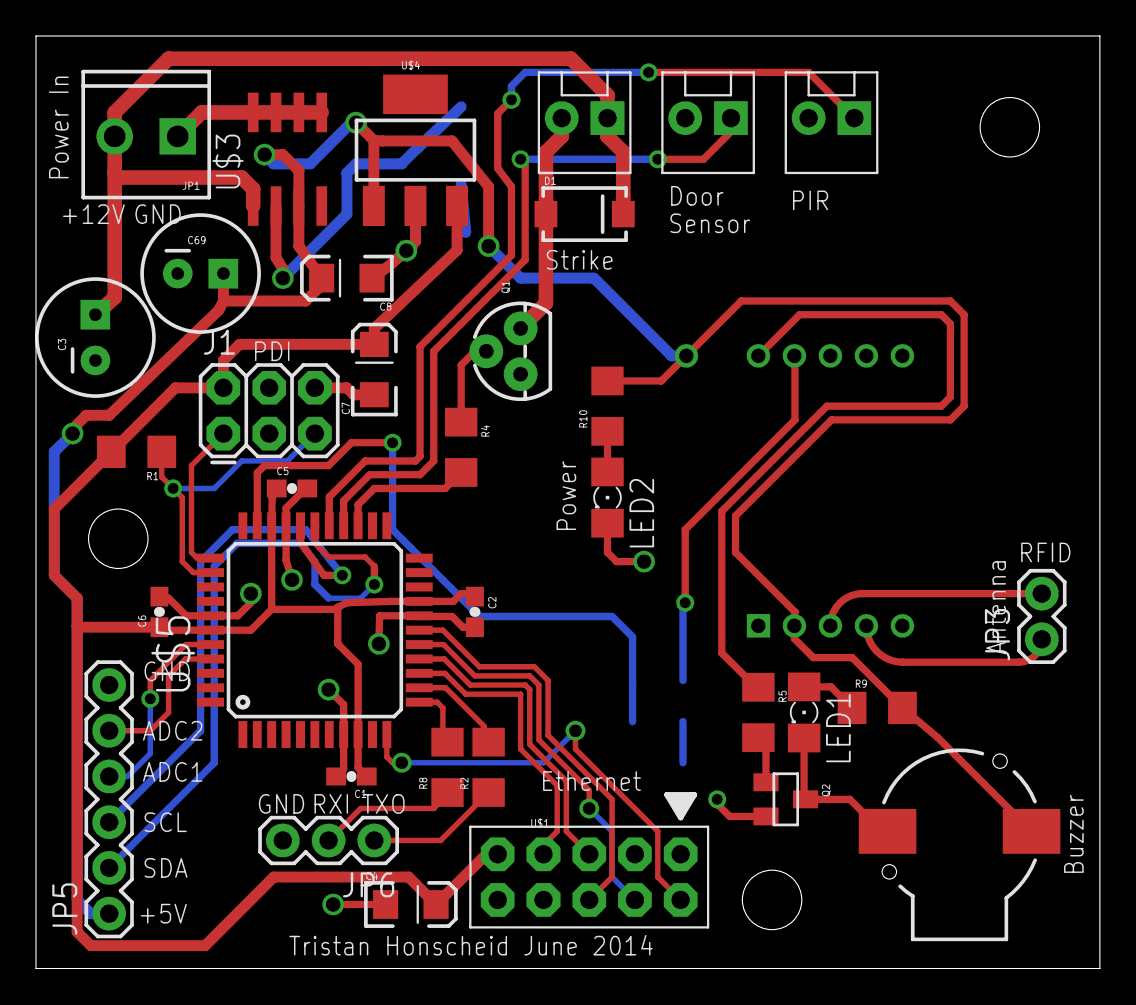
[picture p33: board Opener.brd from above]

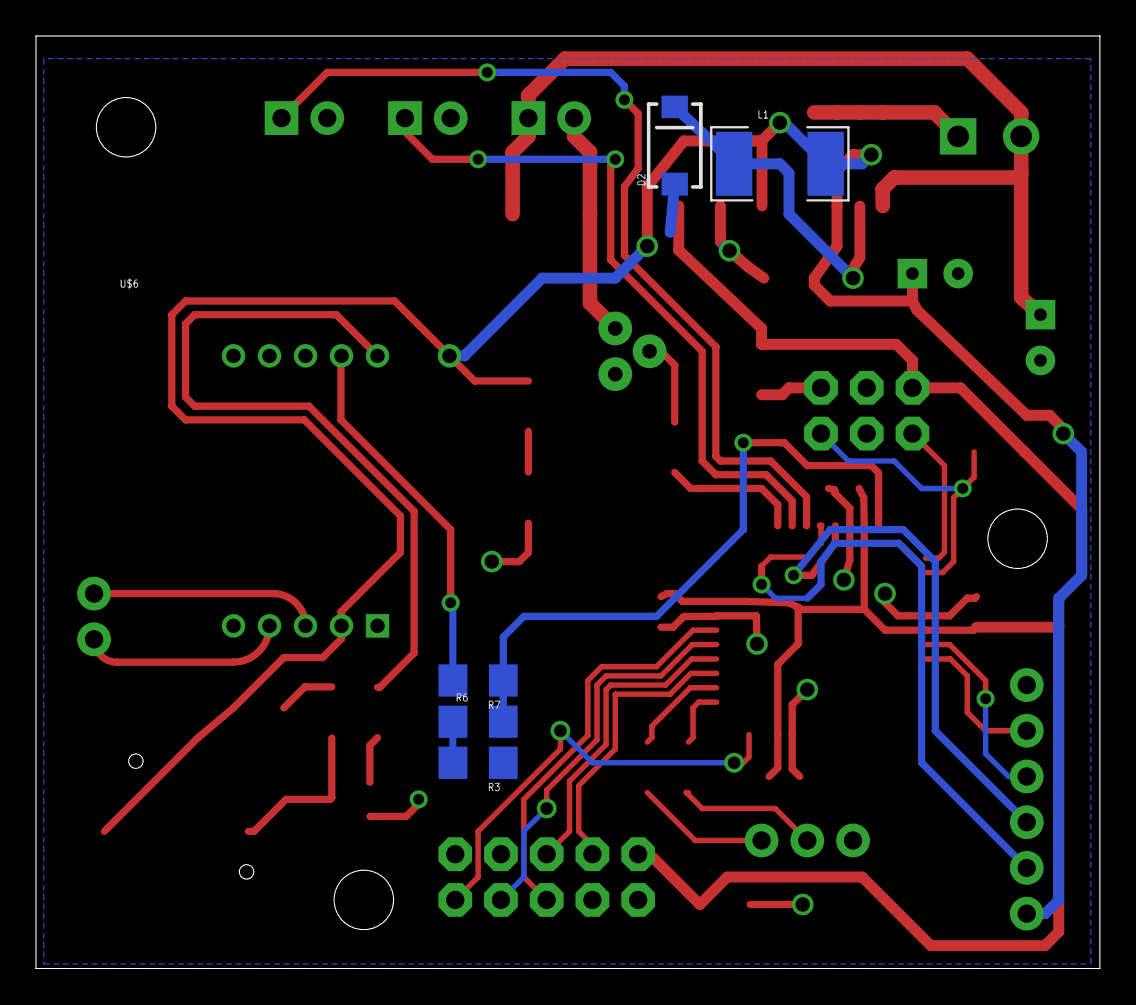
[picture p34: board Opener.brd from below]

Board: 2 copper layers, 59.1 x 51.8 mm, 43 parts (6 on the bottom side), 35 nets.
