tristantech/Dorm-Room-Automation/Boards/Media/UI.brd

## EAGLE design Boards/Media/UI.brd (2014-11-26)

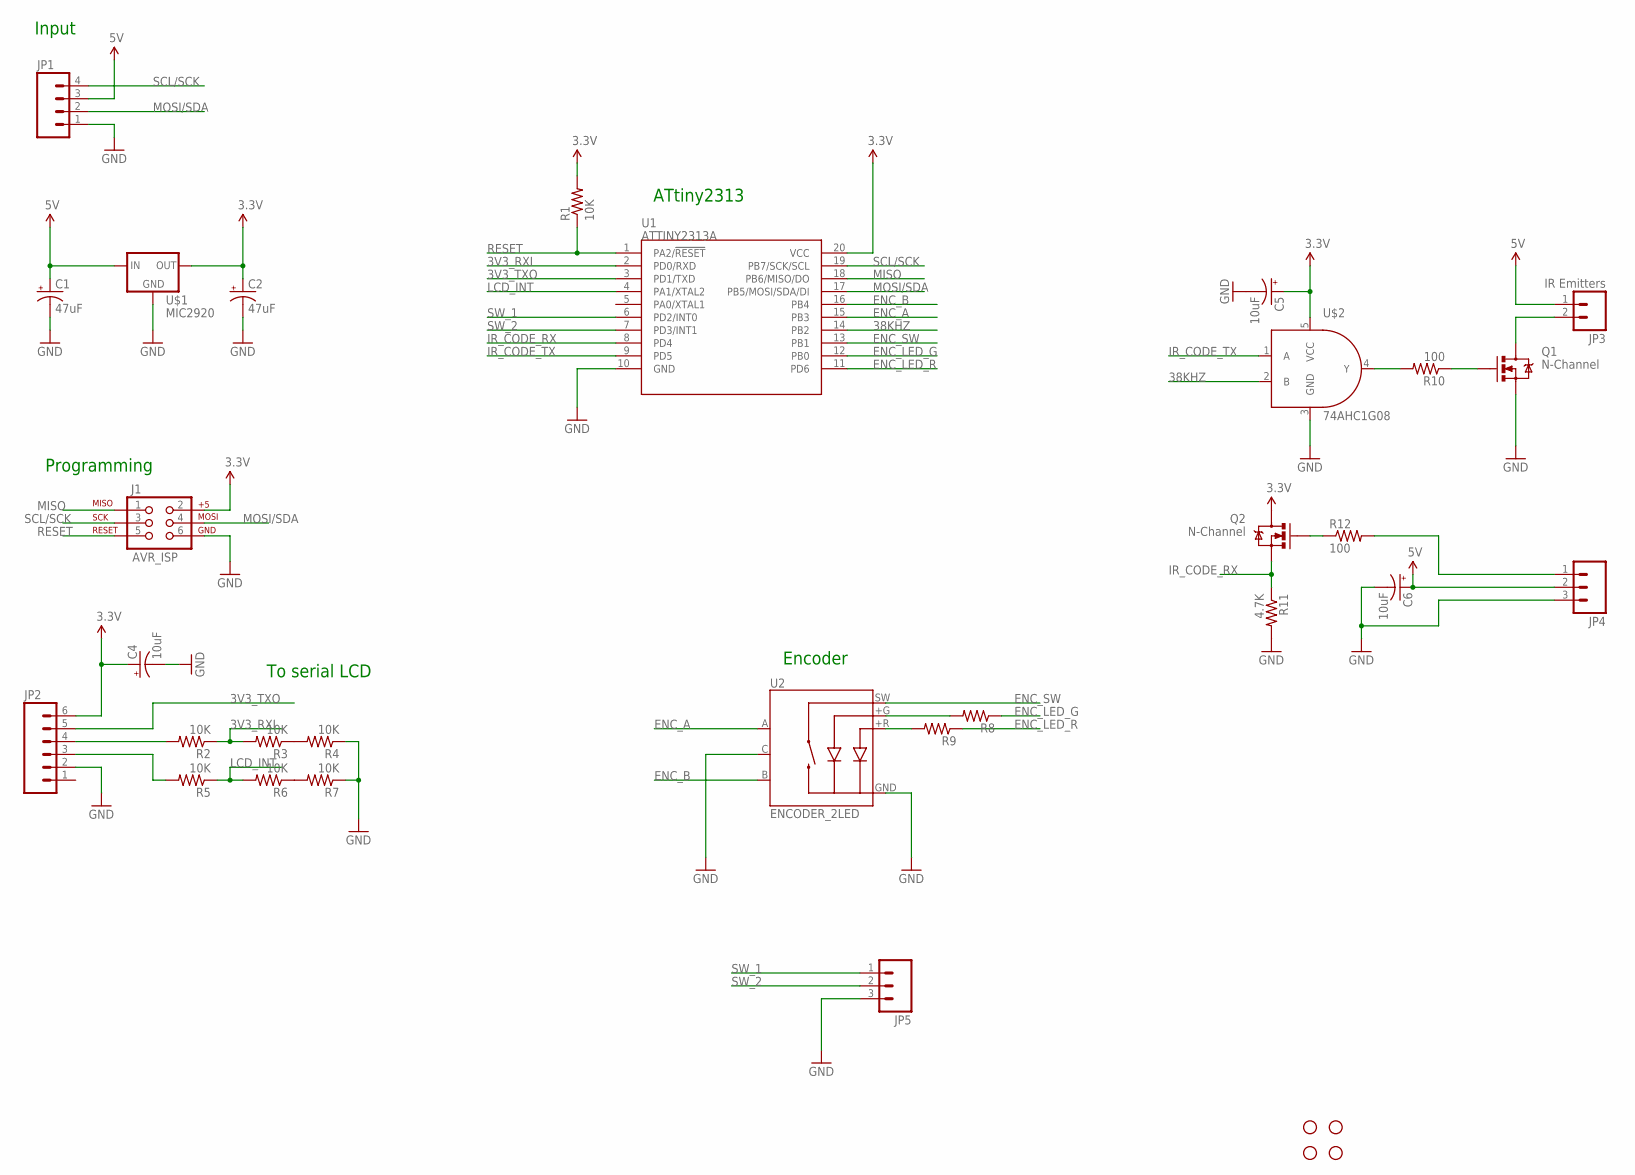
[picture p35: schematic UI.sch]

Parts:
C1, C2: 47uF; CPOL-RADIAL-10UF-25V
C4, C5, C6: 10uF; EIA3216
J1: AVR_ISP; 2X3
JP1: M04POLAR; MOLEX-1X4
JP2: M06POLAR; MOLEX-1X6
JP3: IR Emitters; SCREWTERMINAL-3.5MM-2
JP4, JP5: M03PTH; 1X03
Q1, Q2: N-Channel; SOT23
R1, R2, R3, R4, R5, R6, R7: 10K; 1206
R8, R9: RESISTOR1206; 1206
R10, R12: 100; 1206
R11: 4.7K; 1206
STANDOFF1, STANDOFF2, STANDOFF3, STANDOFF4: STAND-OFF
U1: ATTINY2313A; SOP20W
U2: ENCODER_2LED; ENCODER_LED_2
U$1: MIC2920; SOT223
U$2: 74AHC1G08; SOT23-5

Connections:
3.3V: C2.1 (+), C4.A (+), C5.A (+), J1.2, JP2.6, Q2.3 (D), R1.2, U1.20 (VCC), U$1.3 (OUT), U$2.5 (VCC)
3V3_RXI: R2.1, R3.2, U1.2 (PD0/RXD)
3V3_TXO: JP2.5, U1.3 (PD1/TXD)
5V: C1.1 (+), C6.A (+), JP1.3, JP3.1, JP4.2, U$1.1 (IN)
38KHZ: U1.14 (PB2), U$2.2 (B)
ENC_A: U1.15 (PB3), U2.A
ENC_B: U1.16 (PB4), U2.B
ENC_LED_G: R8.1, U1.12 (PB0)
ENC_LED_R: R9.1, U1.11 (PD6)
ENC_SW: U1.13 (PB1), U2.SW
GND: C1.2 (-), C2.2 (-), C4.C (-), C5.C (-), C6.C (-), J1.6, JP1.1, JP2.2, JP4.3, JP5.3, Q1.2 (S), R4.1, R7.1, R11.2, U1.10 (GND), U2.C, U2.GND (-), U$1.2 (GND), U$2.3 (GND)
IR_CODE_RX: Q2.2 (S), R11.1, U1.8 (PD4)
IR_CODE_TX: U1.9 (PD5), U$2.1 (A)
LCD_INT: R5.1, R6.2, U1.4 (PA1/XTAL2)
MISO: J1.1, U1.18 (PB6/MISO/DO)
MOSI/SDA: J1.4, JP1.2, U1.17 (PB5/MOSI/SDA/DI)
unnamed: R8.2, U2.+G
unnamed: R9.2, U2.+R
unnamed: JP4.1, R12.2
unnamed: JP2.4, R2.2
unnamed: JP2.3, R5.2
unnamed: R3.1, R4.2
unnamed: R6.1, R7.2
unnamed: JP3.2, Q1.3 (D)
unnamed: R10.2, U$2.4 (Y)
unnamed: Q1.1 (G), R10.1
unnamed: Q2.1 (G), R12.1
RESET: J1.5, R1.1, U1.1 (PA2/!RESET)
SCL/SCK: J1.3, JP1.4, U1.19 (PB7/SCK/SCL)
SW_1: JP5.1, U1.6 (PD2/INT0)
SW_2: JP5.2, U1.7 (PD3/INT1)

Notes on the sheet:
To serial LCD
Programming
Input
ATtiny2313
Encoder

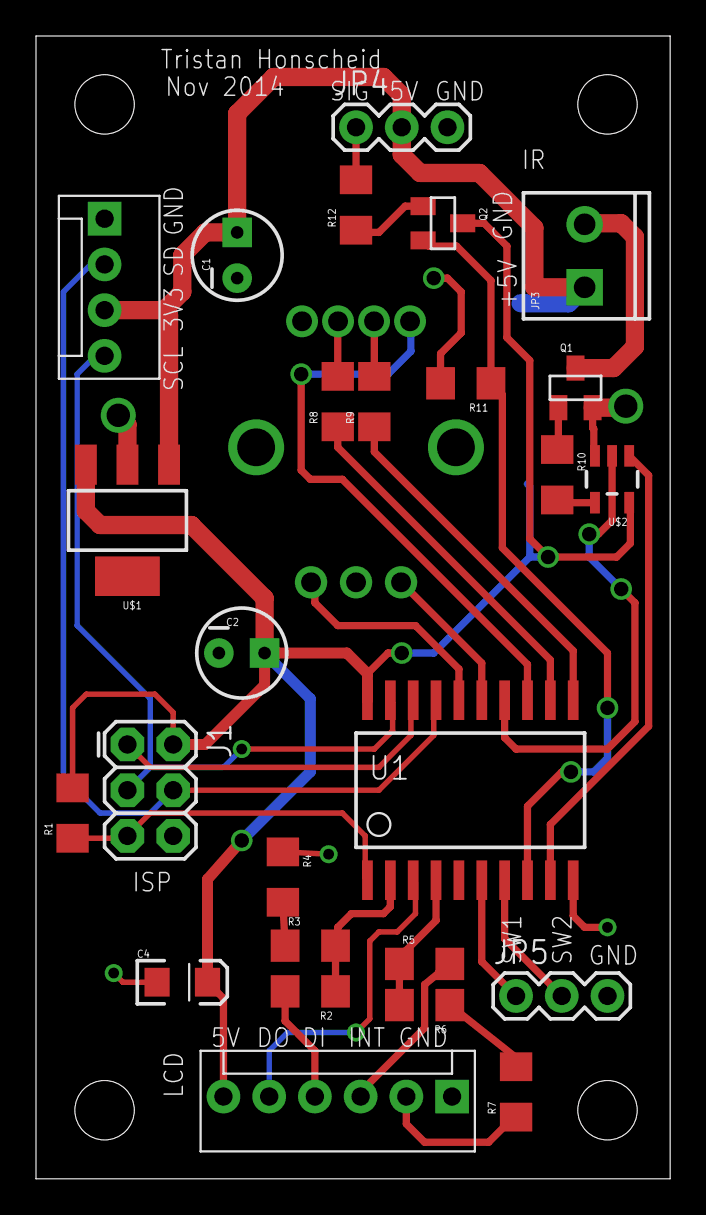
[picture p36: board UI.brd from above]

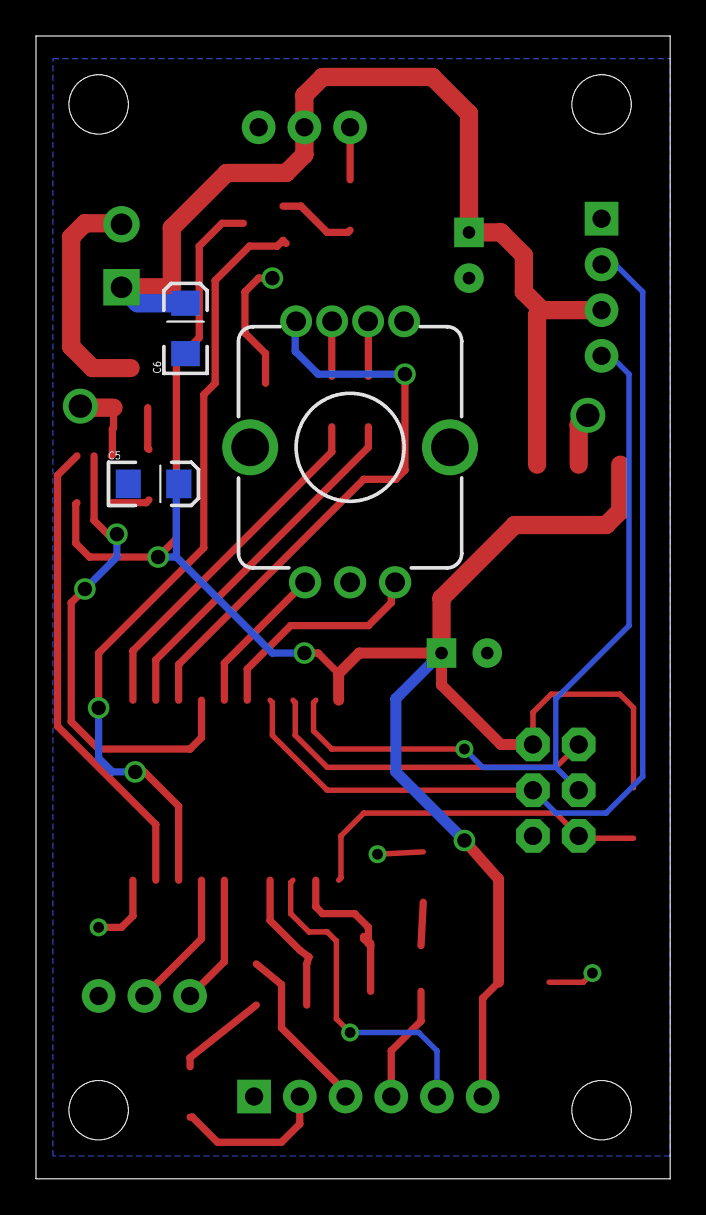
[picture p37: board UI.brd from below]

Board: 2 copper layers, 35.2 x 63.5 mm, 33 parts (3 on the bottom side), 31 nets.
