tristantech/Dorm-Room-Automation/Boards/Media/Adafruit Trellis 4x4 3mm HT16K33.brd

## EAGLE design Boards/Media/Adafruit Trellis 4x4 3mm HT16K33.brd (2014-11-26)

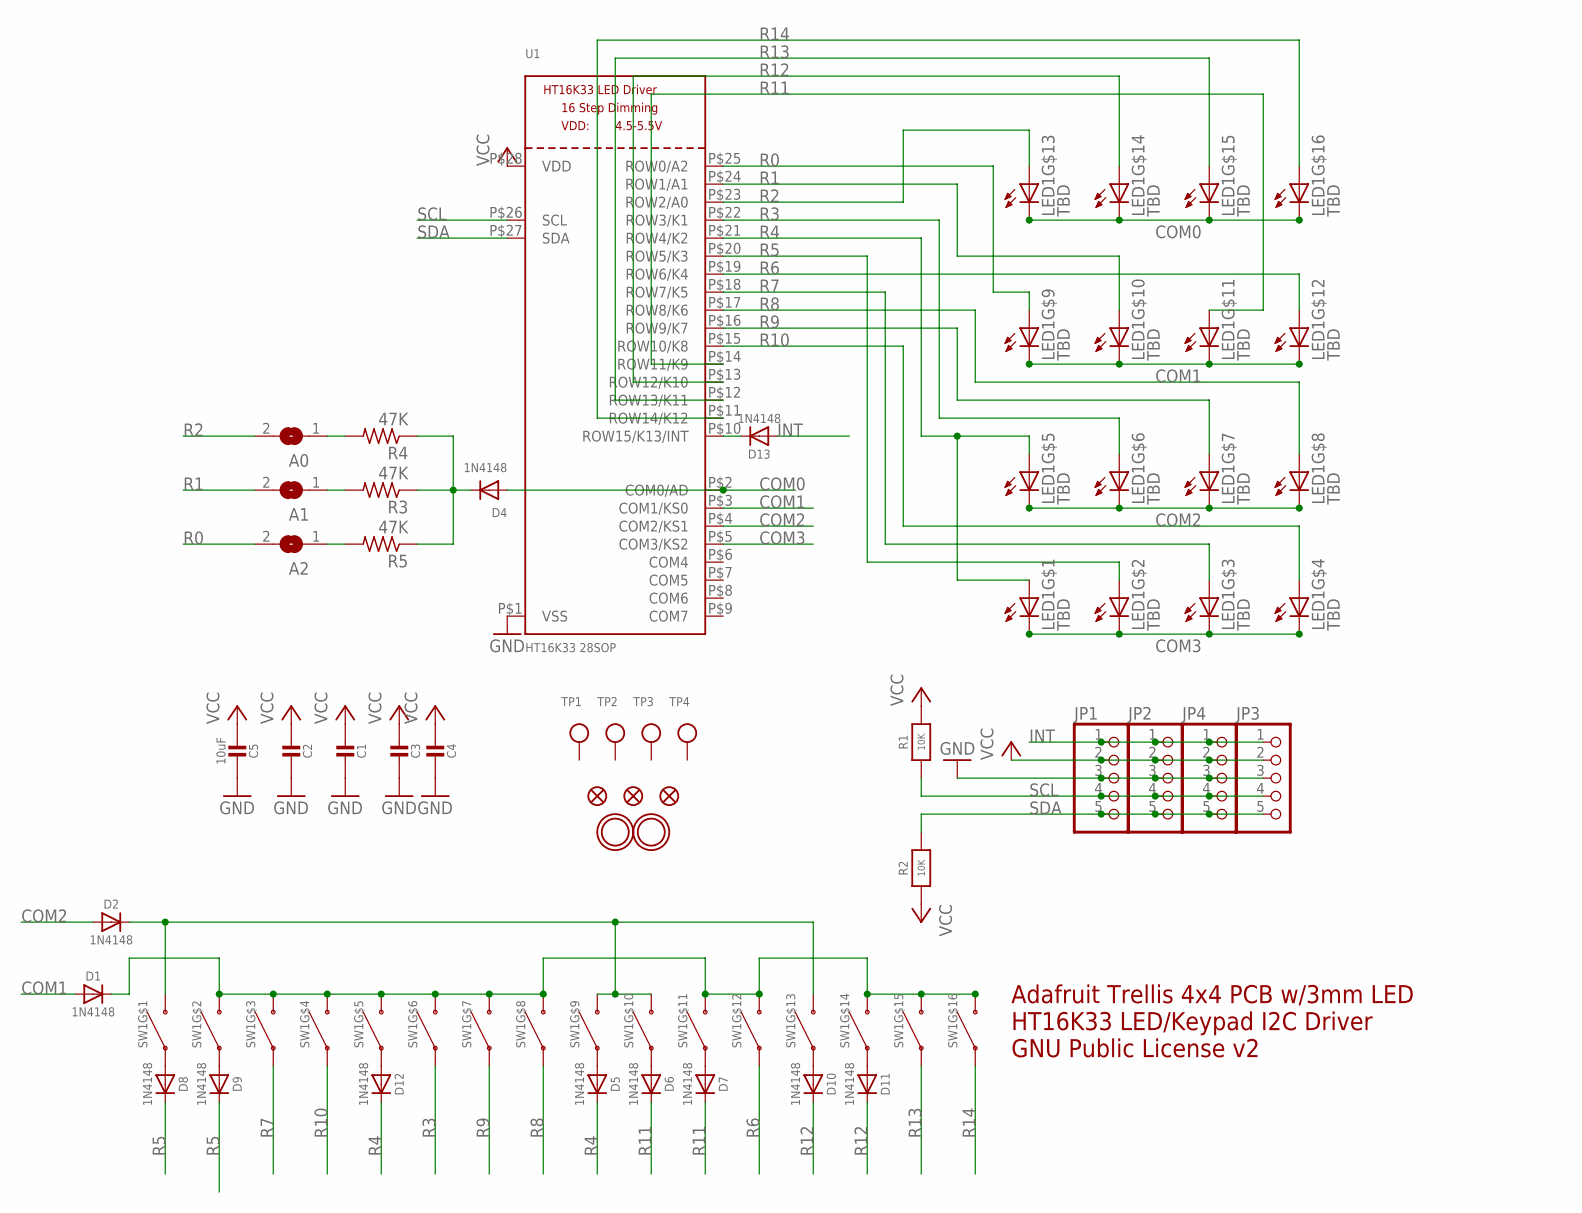
[picture p38: schematic Adafruit Trellis 4x4 3mm HT16K33.sch]

Parts:
A0, A1, A2: SOLDERJUMPERREFLOW_NOPASTE; SOLDERJUMPER_REFLOW_NOPASTE
C1, C2, C3, C4: CAP_CERAMIC_0805; _0805
C5: 10uF; _0805
D1, D2, D5, D6, D7, D8, D9, D10, D11, D12, D13: 1N4148; SOD-323
D4: 1N4148; SOD-323F
FID1, FID2, FID3: FIDUCIAL""; FIDUCIAL_1MM
JP1, JP2, JP3, JP4: HEADER-1X5EDGESMT; 1X5_SMT
LED1: TBD; LED3MM-4X4GRID
R1, R2: 10K; _0805
R3, R4, R5: 47K; R0805
SW1: SWITCH-SILICON-4X4GRID-10MM-5.4MM; ELAST_PAD_SQUARE_10MM_5.4MM_4X4GRID
TP1, TP2, TP3, TP4: TESTPOINT; TESTPOINT_SMT
U1: HT16K33 28SOP; SOP28_300MIL
U$1, U$2: MOUNTINGHOLE2.5; MOUNTINGHOLE_2.5_PLATED

Connections:
COM0: D4.A, LED1.K13 (C), LED1.K14 (C), LED1.K15 (C), LED1.K16 (C), U1.P$2 (COM0/AD)
COM1: D1.A, LED1.K9 (C), LED1.K10 (C), LED1.K11 (C), LED1.K12 (C), U1.P$3 (COM1/KS0)
COM2: D2.A, LED1.K5 (C), LED1.K6 (C), LED1.K7 (C), LED1.K8 (C), U1.P$4 (COM2/KS1)
COM3: LED1.K1 (C), LED1.K2 (C), LED1.K3 (C), LED1.K4 (C), U1.P$5 (COM3/KS2)
GND: C1.1, C2.1, C3.1, C4.1, C5.1, JP1.3, JP2.3, JP3.3, JP4.3, U1.P$1 (VSS)
INT: D13.A, JP1.1, JP2.1, JP3.1, JP4.1
unnamed: D2.C, SW1.B1, SW1.B9, SW1.B10, SW1.B13
unnamed: D13.C, U1.P$10 (ROW15/K13/INT)
unnamed: D5.A, SW1.A9
unnamed: D6.A, SW1.A10
unnamed: D1.C, SW1.B2, SW1.B3, SW1.B4, SW1.B5, SW1.B6, SW1.B7, SW1.B8, SW1.B11, SW1.B12, SW1.B14, SW1.B15, SW1.B16
unnamed: D7.A, SW1.A11
unnamed: D8.A, SW1.A1
unnamed: D9.A, SW1.A2
unnamed: A2.1, R5.2
unnamed: D10.A, SW1.A13
unnamed: D11.A, SW1.A14
unnamed: D12.A, SW1.A5
unnamed: D4.C, R3.1, R4.1, R5.1
unnamed: A1.1, R3.2
unnamed: A0.1, R4.2
R0: A2.2, LED1.A9 (A), U1.P$25 (ROW0/A2)
R1: A1.2, LED1.A10 (A), U1.P$24 (ROW1/A1)
R2: A0.2, LED1.A13 (A), U1.P$23 (ROW2/A0)
R3: LED1.A6 (A), SW1.A6, U1.P$22 (ROW3/K1)
R4: D5.C, D12.C, LED1.A1 (A), LED1.A5 (A), U1.P$21 (ROW4/K2)
R5: D8.C, D9.C, LED1.A2 (A), U1.P$20 (ROW5/K3)
R6: LED1.A12 (A), SW1.A12, U1.P$19 (ROW6/K4)
R7: LED1.A3 (A), SW1.A3, U1.P$18 (ROW7/K5)
R8: LED1.A8 (A), SW1.A8, U1.P$17 (ROW8/K6)
R9: LED1.A7 (A), SW1.A7, U1.P$16 (ROW9/K7)
R10: LED1.A4 (A), SW1.A4, U1.P$15 (ROW10/K8)
R11: D6.C, D7.C, LED1.A11 (A), U1.P$14 (ROW11/K9)
R12: D10.C, D11.C, LED1.A14 (A), U1.P$13 (ROW12/K10)
R13: LED1.A15 (A), SW1.A15, U1.P$12 (ROW13/K11)
R14: LED1.A16 (A), SW1.A16, U1.P$11 (ROW14/K12)
SCL: JP1.4, JP2.4, JP3.4, JP4.4, R1.1, U1.P$26 (SCL)
SDA: JP1.5, JP2.5, JP3.5, JP4.5, R2.2, U1.P$27 (SDA)
VCC: C1.2, C2.2, C3.2, C4.2, C5.2, JP1.2, JP2.2, JP3.2, JP4.2, R1.2, R2.1, U1.P$28 (VDD)

Notes on the sheet:
Adafruit Trellis 4x4 PCB w/3mm LED HT16K33 LED/Keypad I2C Driver GNU Public License v2

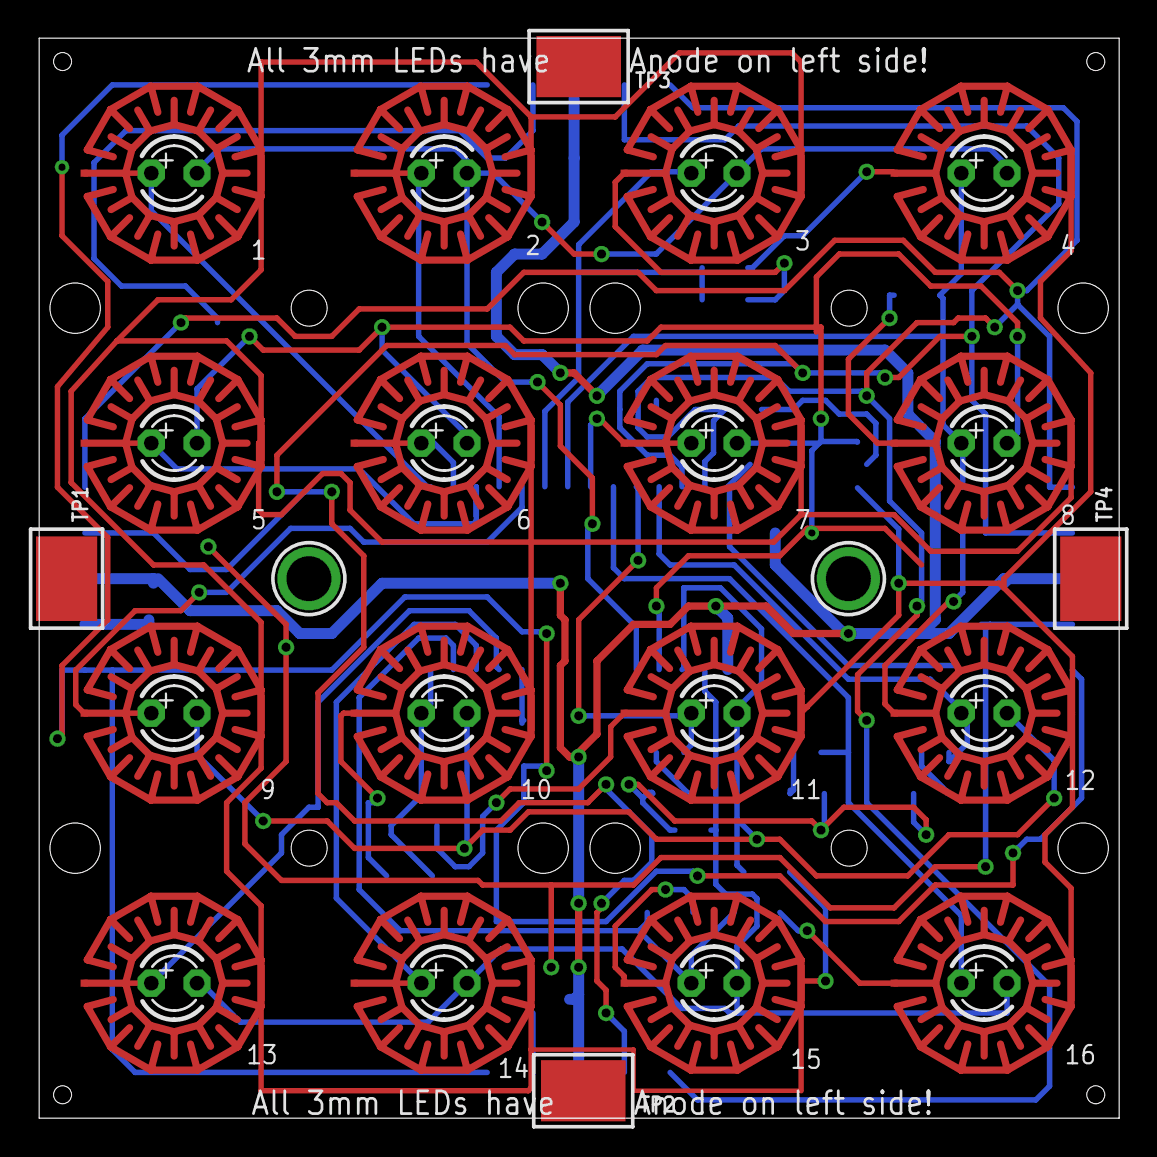
[picture p39: board Adafruit Trellis 4x4 3mm HT16K33.brd from above]

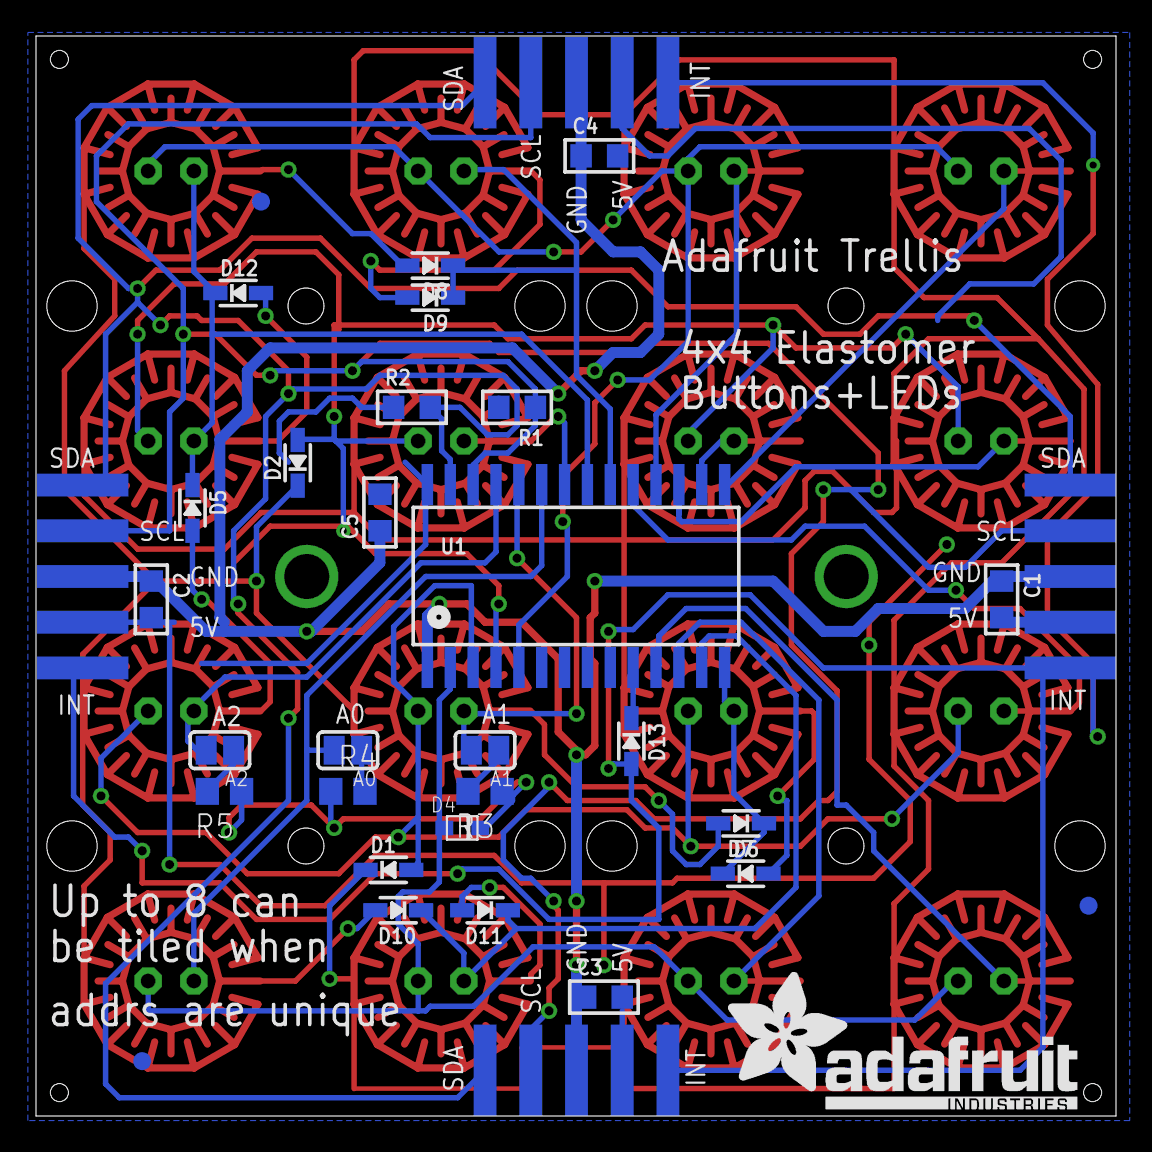
[picture p40: board Adafruit Trellis 4x4 3mm HT16K33.brd from below]

Board: 2 copper layers, 60.0 x 60.0 mm, 42 parts (34 on the bottom side), 39 nets.

Other parts of the board:
U$3: ADAFRUIT_TEXT_20MM
