tristantech/Dorm-Room-Automation/Boards/Media/amplifier.brd

## EAGLE design Boards/Media/amplifier.brd (2014-11-01)

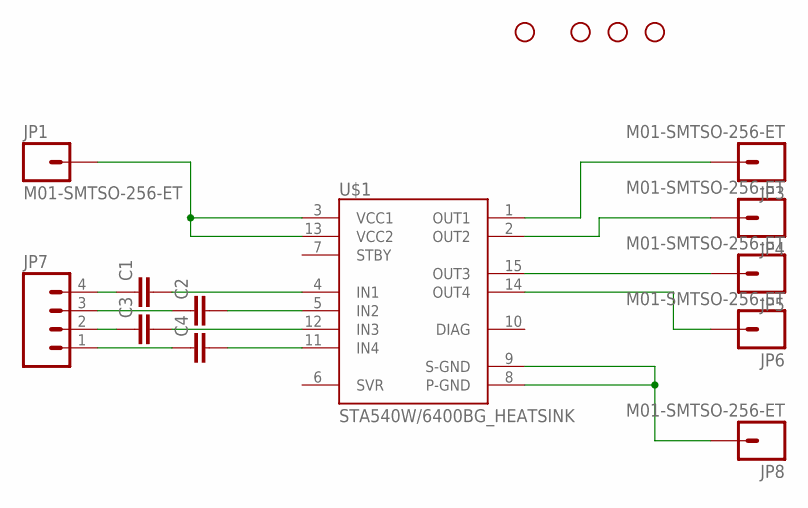
[picture p41: schematic amplifier.sch]

Parts:
C1, C2, C3, C4: CAP1206; 1206
JP1, JP3, JP4, JP5, JP6, JP8: M01-SMTSO-256-ET; SMTSO-256-ET
JP7: M04PTH; 1X04
STANDOFF1, STANDOFF2, STANDOFF3, STANDOFF4: STAND-OFF
U$1: STA540W/6400BG_HEATSINK; MULTIWATT15_6400BGHEATSINK

Connections:
unnamed: JP3.P$1, U$1.1 (OUT1)
unnamed: JP4.P$1, U$1.2 (OUT2)
unnamed: JP5.P$1, U$1.15 (OUT3)
unnamed: JP6.P$1, U$1.14 (OUT4)
unnamed: JP8.P$1, U$1.8 (P-GND), U$1.9 (S-GND)
unnamed: JP1.P$1, U$1.3 (VCC1), U$1.13 (VCC2)
unnamed: C4.2, U$1.11 (IN4)
unnamed: C3.2, U$1.12 (IN3)
unnamed: C2.2, U$1.5 (IN2)
unnamed: C1.2, U$1.4 (IN1)
unnamed: C1.1, JP7.4
unnamed: C2.1, JP7.3
unnamed: C3.1, JP7.2
unnamed: C4.1, JP7.1

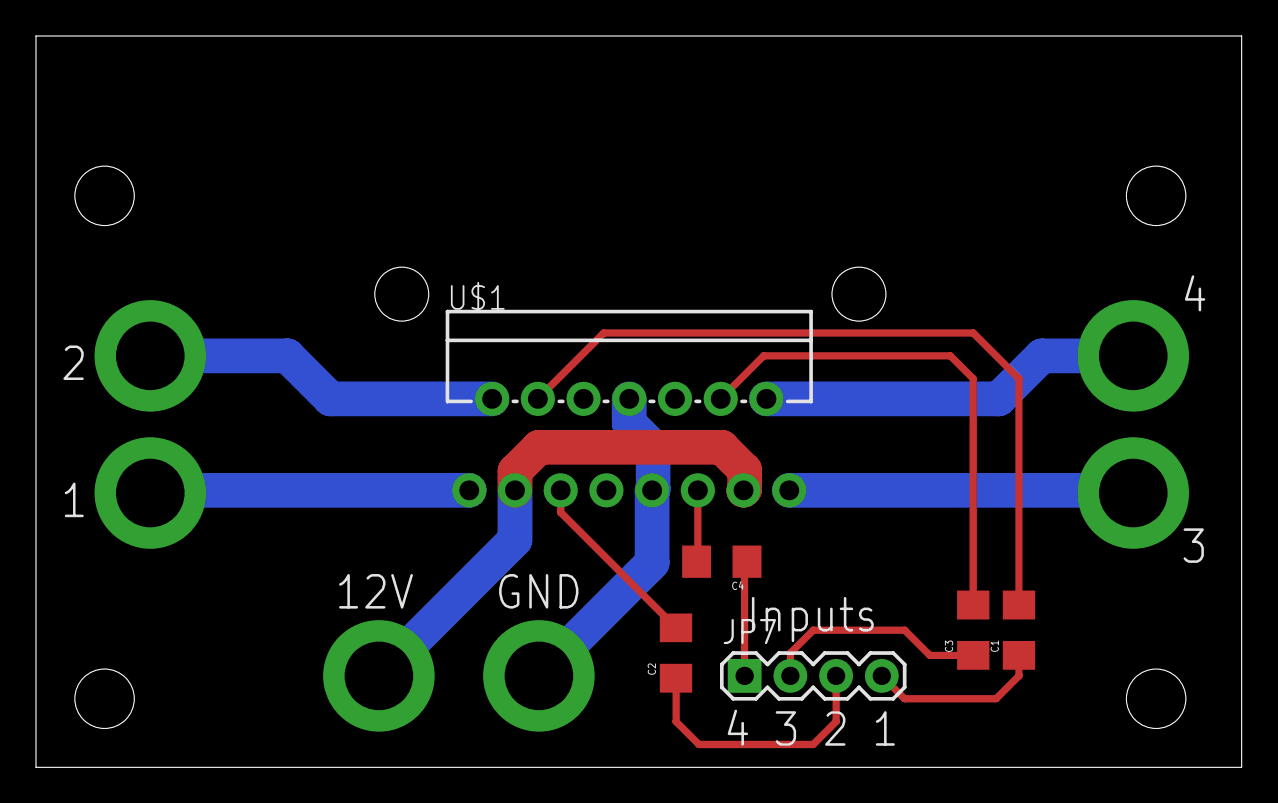
[picture p42: board amplifier.brd from above]

Board: 2 copper layers, 67.0 x 40.6 mm, 16 parts (0 on the bottom side), 14 nets.
