tristantech/Dorm-Room-Automation/(commit log)

2014-10-31 First commit of existing code to Github
    [Main.brd, Main.sch, Opener.brd, Opener.sch, PWM_Board.brd, PWM_Board.sch, Window.brd, Window.sch]
2014-11-01 Finished PWM lighting board, now uses a ribbon cable to connect to a break out terminal board
    [PWM_Board.brd, PWM_Board.sch]
2014-11-01 Added small breakout board for the STA540 amplifier
    [amplifier.brd, amplifier.sch]
2014-11-26 Lots of prgress on media related boards.
    [Adafruit Trellis 4x4 3mm HT16K33.brd, Adafruit Trellis 4x4 3mm HT16K33.sch, East Campus.dwg, UI.brd, UI.sch, distribution.brd, distribution.sch, dsp.brd]
2014-11-27 Changed to a PI GPIO header (ditching the NGW100)
    [distribution.brd, distribution.sch]
2014-12-01 DSP sch nearly complete, added most components. Still needs reset generator and final check
    [distribution.brd, dsp.brd, dsp.sch]
2014-12-03 Began laying out DSP board
    [dsp.brd, dsp.sch]
2014-12-10 DSP Board finished!
    [dsp.brd, dsp.sch]
2014-12-10 Prepared board for production, last minute error checks and rotations
    [Main.brd, Opener.brd, PWM_Board.brd, Window.brd, Window.sch, distribution.brd, distribution.sch, dsp.sch]
2014-12-12 Final gerbers and board updates! Fixed PCB violations, now passes FreeDFM check!
    [Main.GBL, Main.GBO, Main.GBS, Main.GTL, Main.GTO, Main.GTP, Main.GTS, Opener.GBL]
